HedayaAli/Self-balancing-/sbr-design/Our project/blue-wheel-for-hobby-robotics/Renderings/Isometric view.PNG

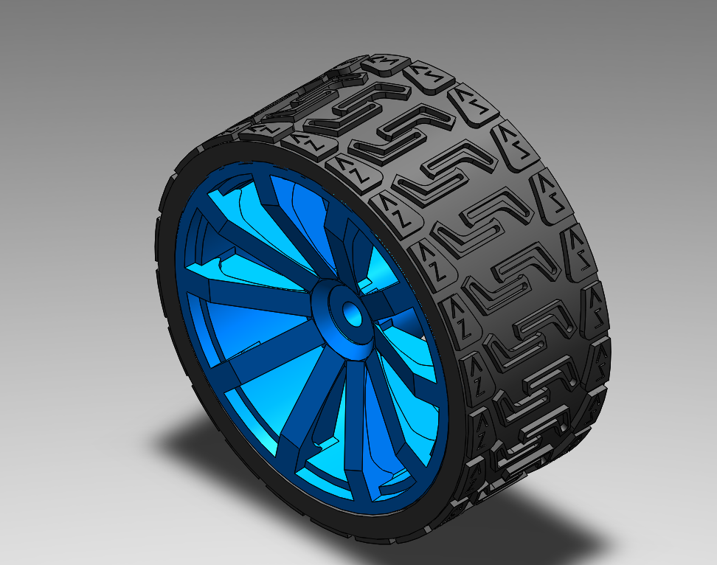
sbr-design/Our project/blue-wheel-for-hobby-robotics/Renderings/Isometric view.PNG
