HedayaAli/Self-balancing-/sbr-design/3.JPG

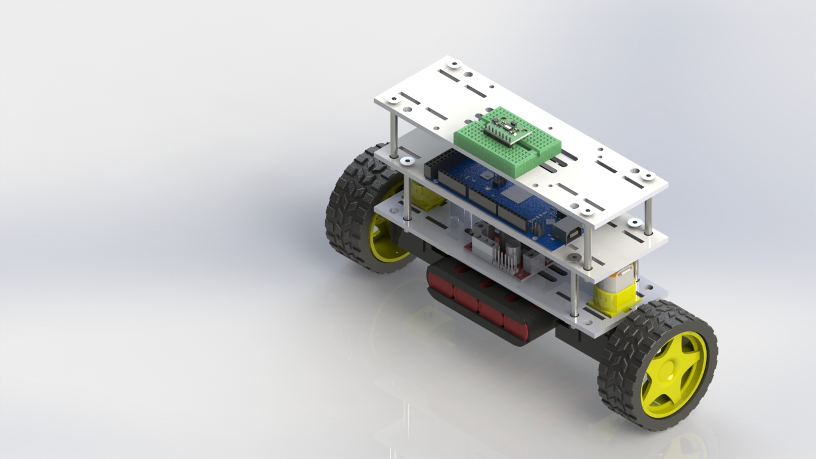
sbr-design/3.JPG
