HedayaAli/Self-balancing-/Presentation/Presentation.pdf

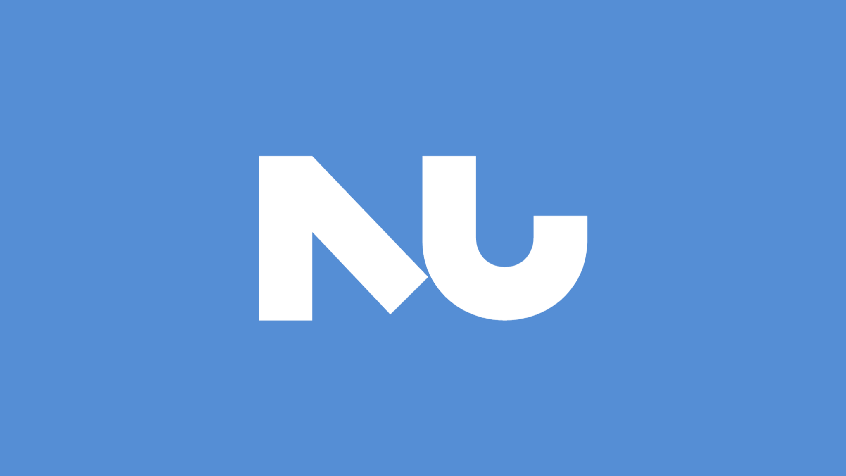
[picture p21: page 1]
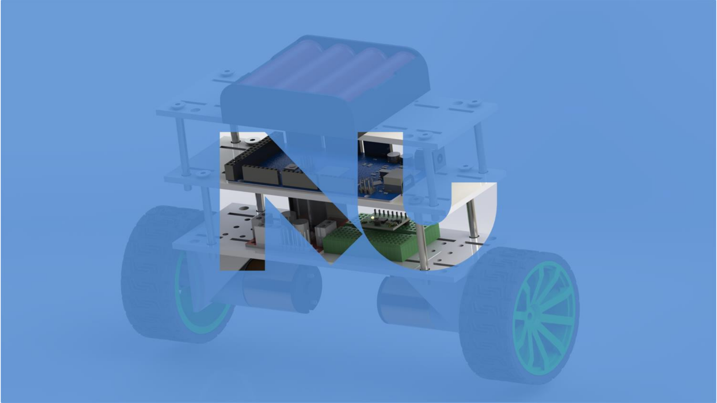
[picture p22: page 2]
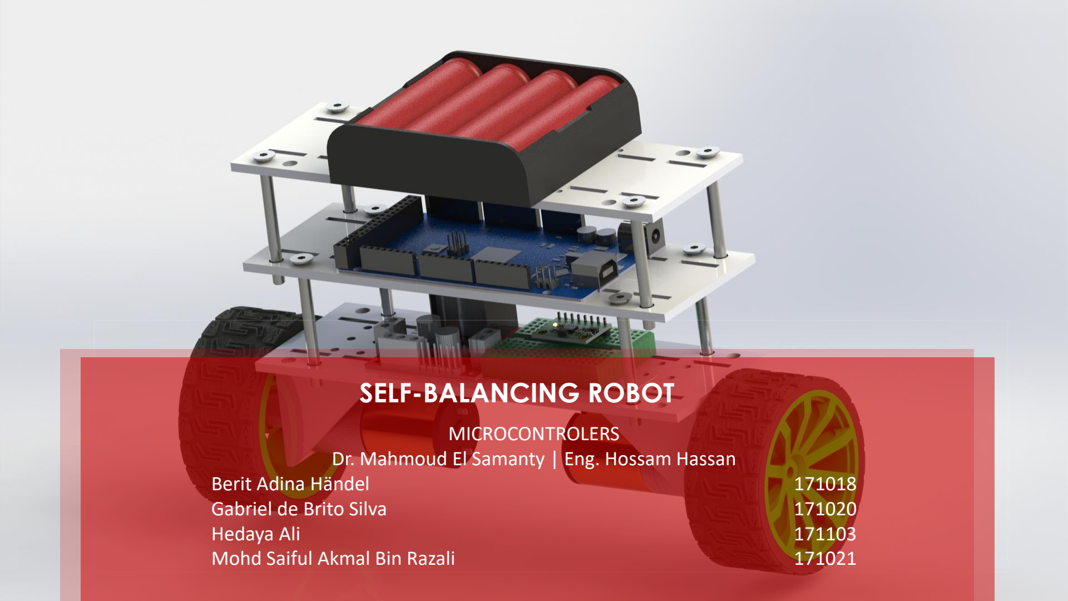
[picture p23: page 3]

### SELF-BALANCING ROBOT

MICROCONTROLERS
Dr. Mahmoud El Samanty | Eng. Hossam Hassan
Berit Adina Händel | 171018
Gabriel de Brito Silva | 171020
Hedaya Ali | 171103
Mohd Saiful Akmal Bin Razali | 171021

### OBJECTIVES

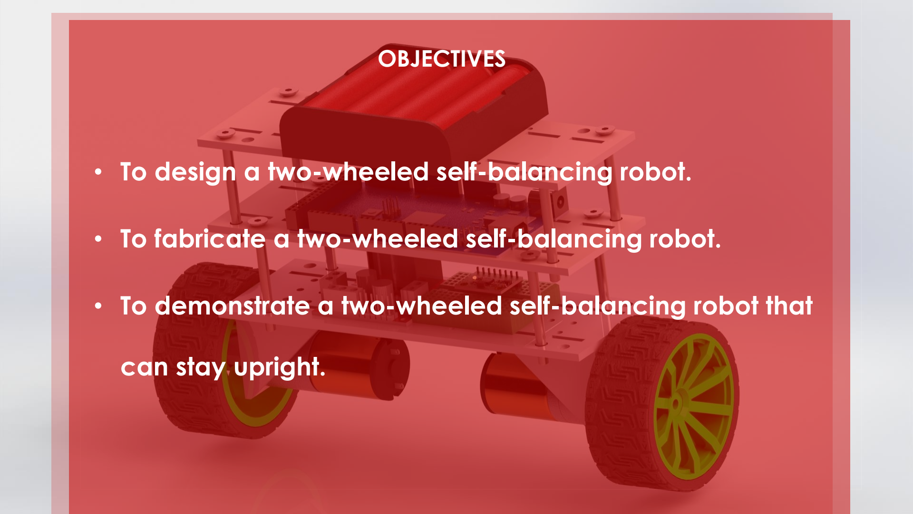
[picture p24: page 4]

- To design a two-wheeled self-balancing robot.
- To fabricate a two-wheeled self-balancing robot.

## - To demonstrate a two-wheeled self-balancing robot that

can stay upright.

# INVERTED PENDULUM

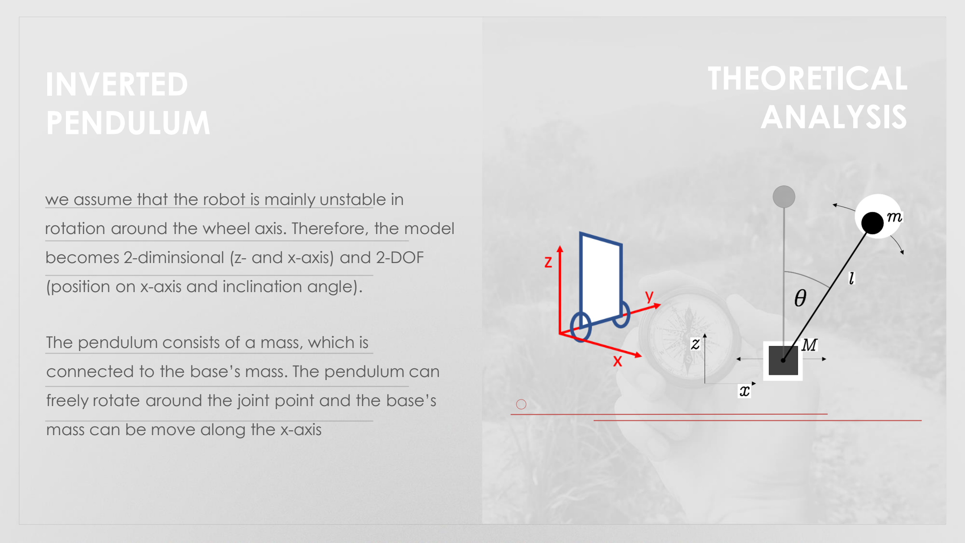
[picture p25: page 5]

The pendulum consists of a mass, which is

connected to the base’s mass. The pendulum can

freely rotate around the joint point and the base’s

mass can be move along the x-axis

we assume that the robot is mainly unstable in

rotation around the wheel axis. Therefore, the model

becomes 2-diminsional (z- and x-axis) and 2-DOF

(position on x-axis and inclination angle).

# THEORETICAL ANALYSIS

# THEORETICAL ANALYSIS

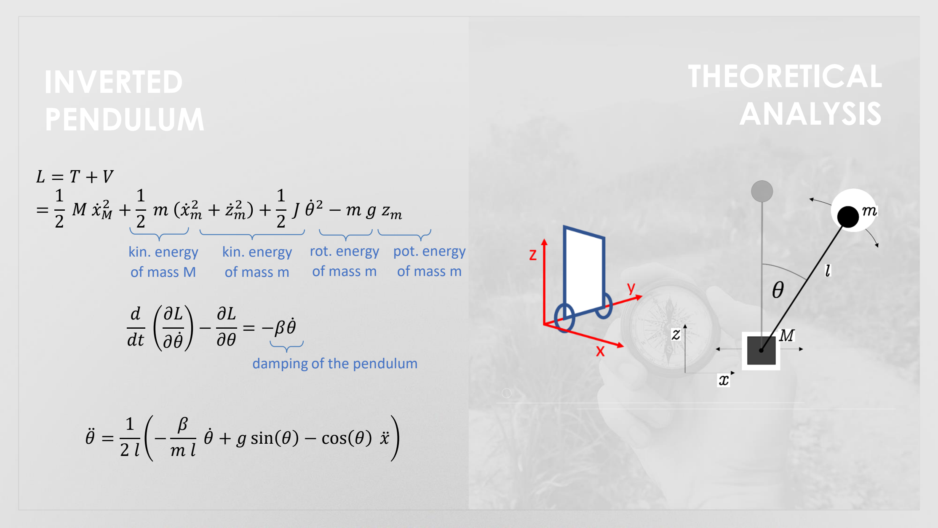
[picture p26: page 6]

L = T + V

=

1
2

M xሶM

2 +

1
2

m xሶm

2 + zሶm

2 +

1
2

J θሶ² − m g zm

kin. energy
of mass m

kin. energy
of mass M

rot. energy
of mass m

pot. energy
of mass m

d
dt

∂L
∂θሶ

−

∂L
∂θ

= −βθሶ

damping of the pendulum

θሷ=

1
2 l

−

β
m l

θሶ + g sin θ − cos θ xሷ

# INVERTED PENDULUM

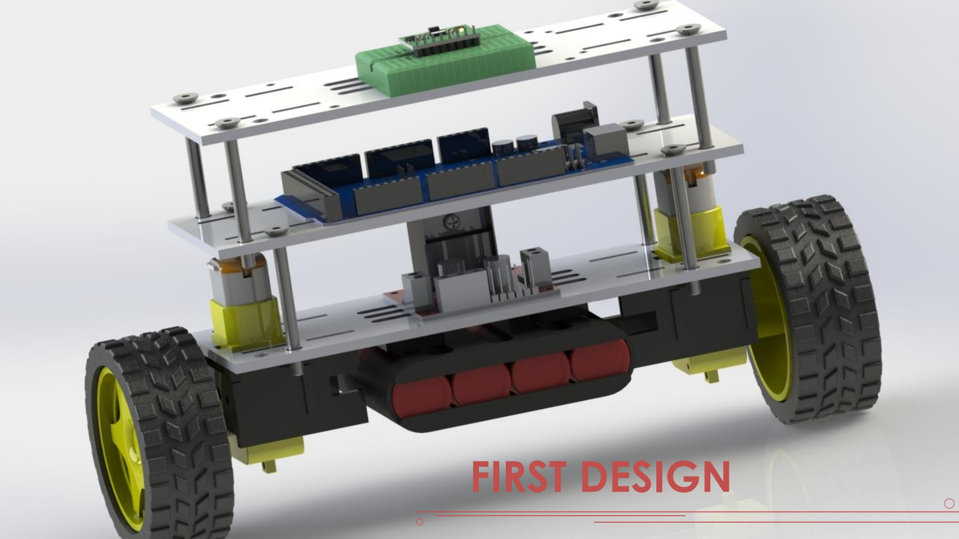
[picture p27: page 7]

# FIRST DESIGN

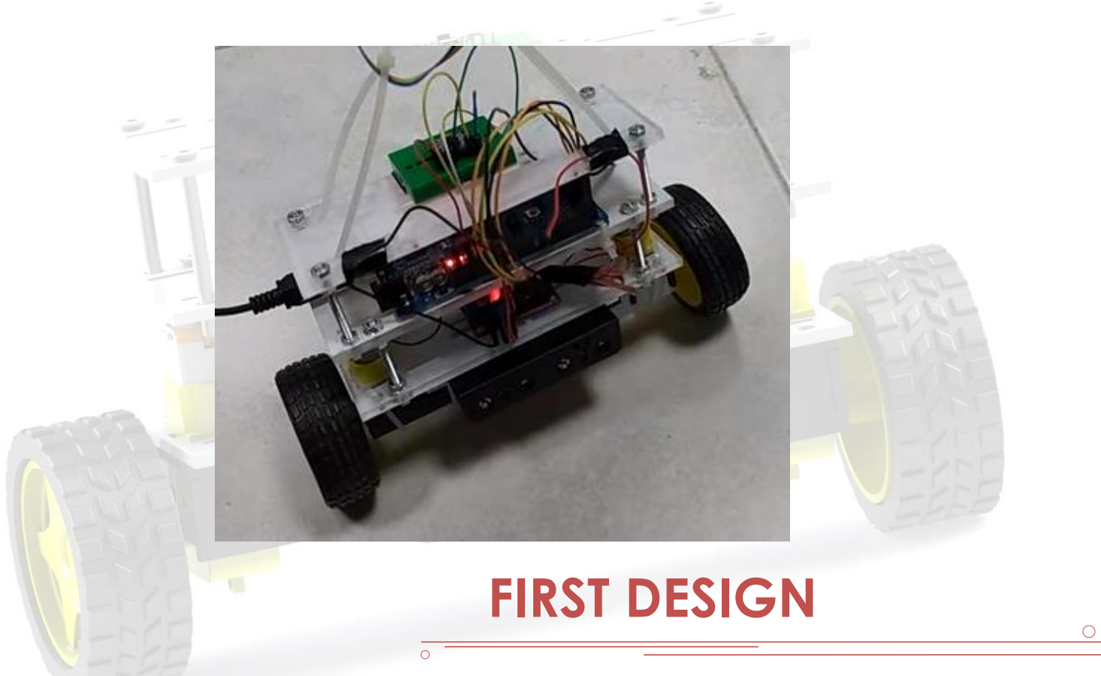
[picture p28: page 8]

# FIRST DESIGN

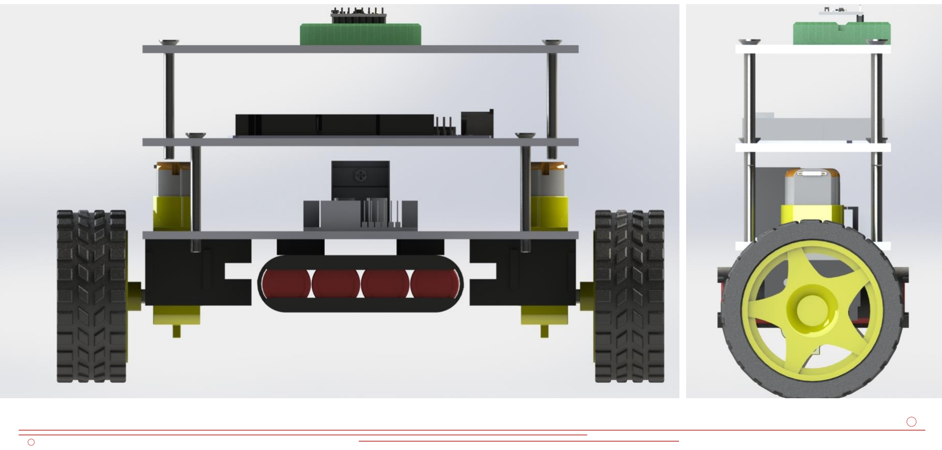
[picture p29: page 9]

# NOME DO APRESENTADOR

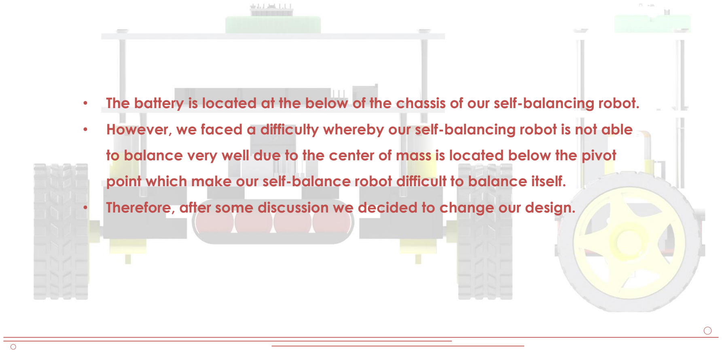
[picture p30: page 10]

# NOME DO APRESENTADOR

- The battery is located at the below of the chassis of our self-balancing robot.
- However, we faced a difficulty whereby our self-balancing robot is not able

to balance very well due to the center of mass is located below the pivot

point which make our self-balance robot difficult to balance itself.

- Therefore, after some discussion we decided to change our design.

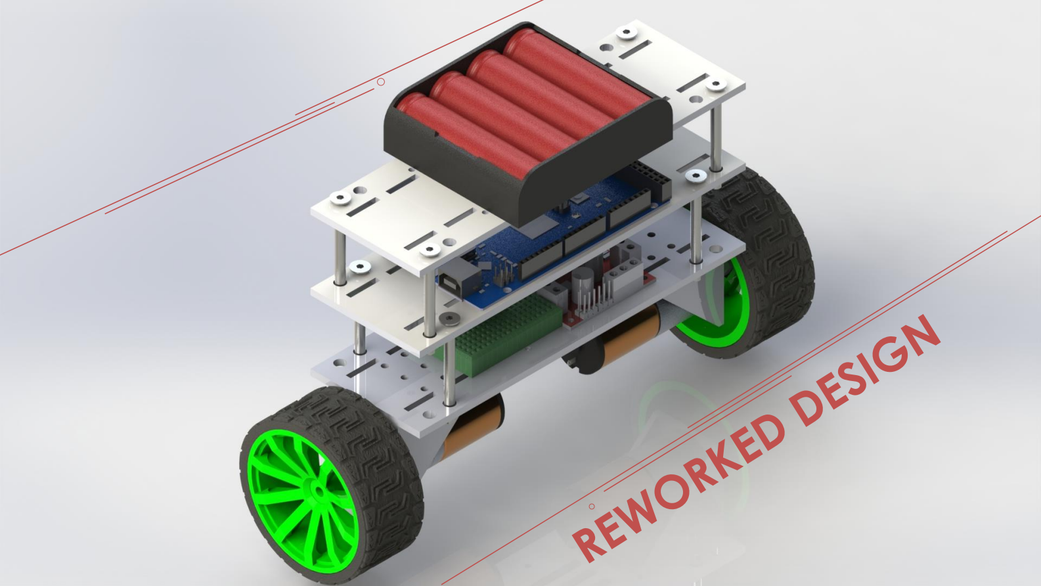
[picture p31: page 11]

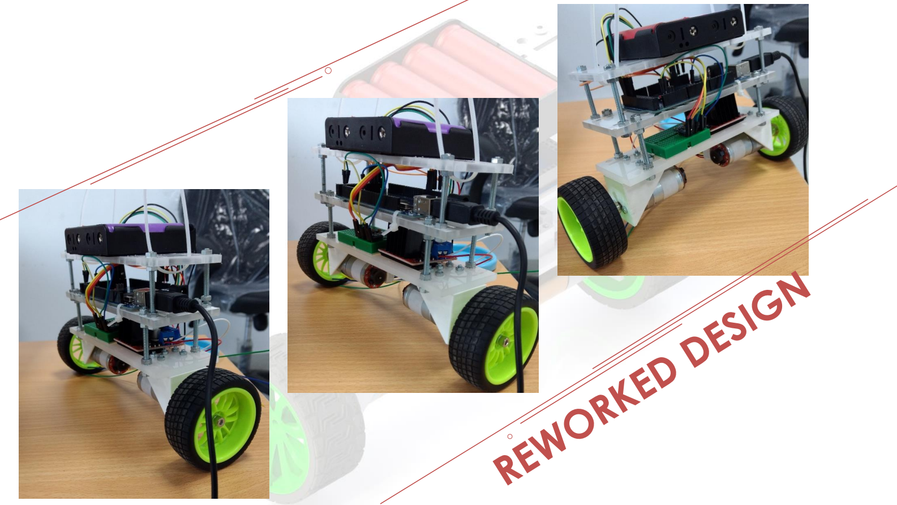
[picture p32: page 12]

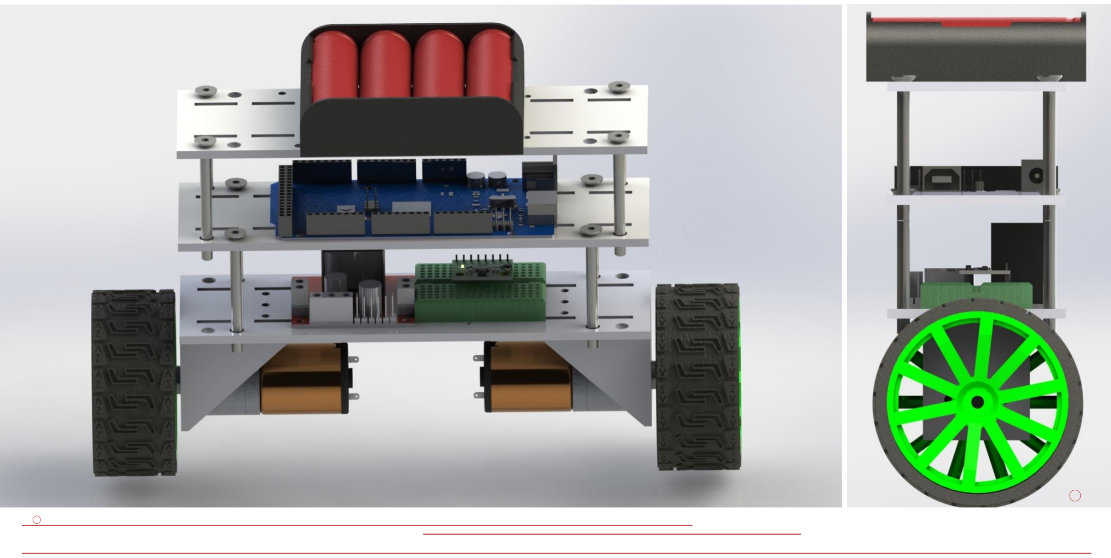
[picture p33: page 13]

# NOME DO APRESENTADOR

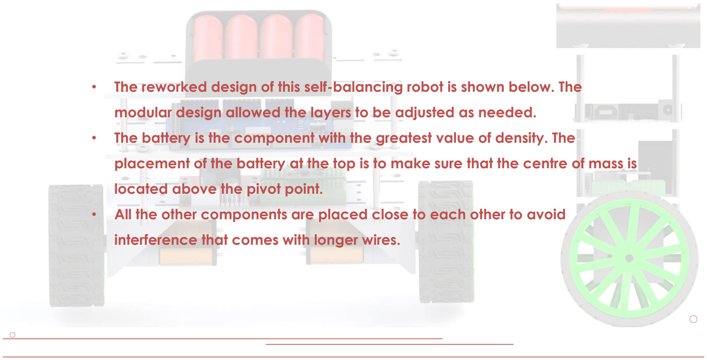
[picture p34: page 14]

# NOME DO APRESENTADOR

- The reworked design of this self-balancing robot is shown below. The

modular design allowed the layers to be adjusted as needed.

- The battery is the component with the greatest value of density. The

placement of the battery at the top is to make sure that the centre of mass is

located above the pivot point.

- All the other components are placed close to each other to avoid

interference that comes with longer wires.

# COMPONENTS AND CONNECTIONS

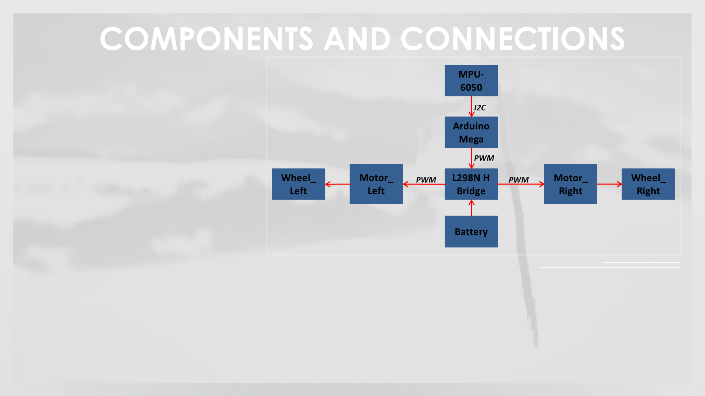
[picture p35: page 15]

# COMPONENTS AND CONNECTIONS

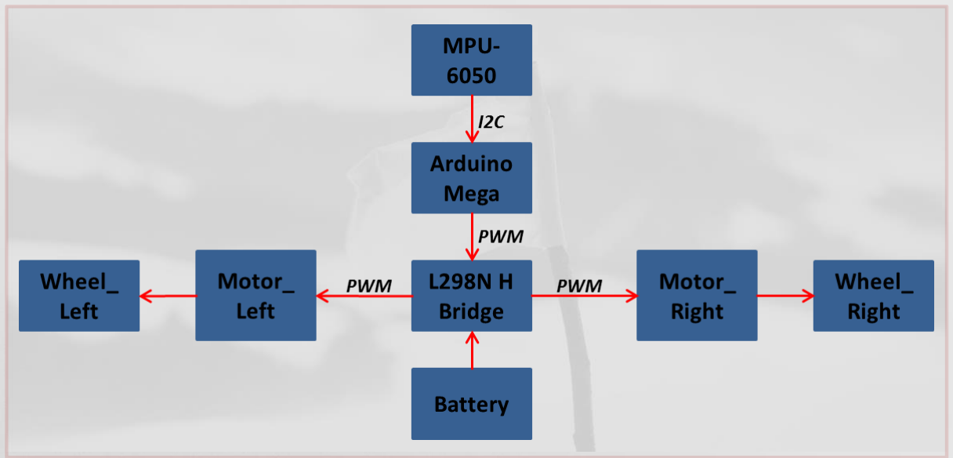
[picture p36: figure]

- Arduino Mega will read a
raw | data | from | the
measurement | sub-system
which in this case is MPU-6050.
- Arduino Mega reads raw
data from the measurement
sub-system and sends PWM
signals to the motor driver to be converted to mechanical motion.

# COMPONENTS AND CONNECTIONS

- | When | fresh | IMU | data | is
received, the MPU-6050 filters out sensor noise, and then fuse the data from the two sensors together to produce a single reading of tilt.
- Once the current tilt is known, the MPU-6050 calculates the error from the desired tilt, in this case the vertical, and then uses PID to control the PWM output to the motor driver sub-
| system.

# SIMULATION

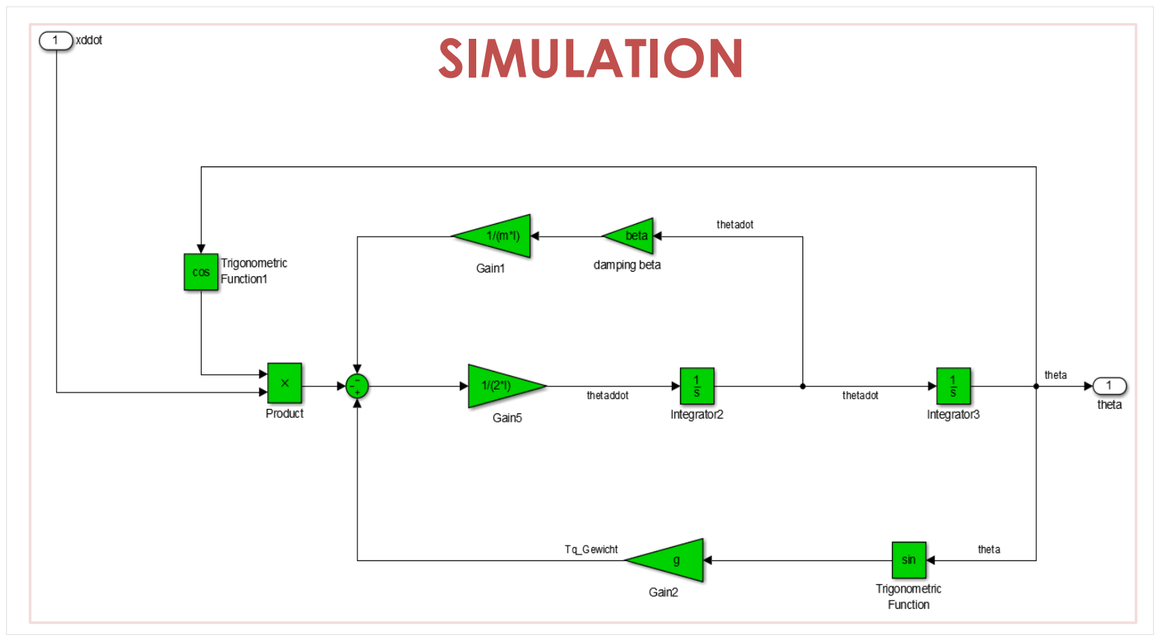
[picture p37: page 18]

# SIMULATION

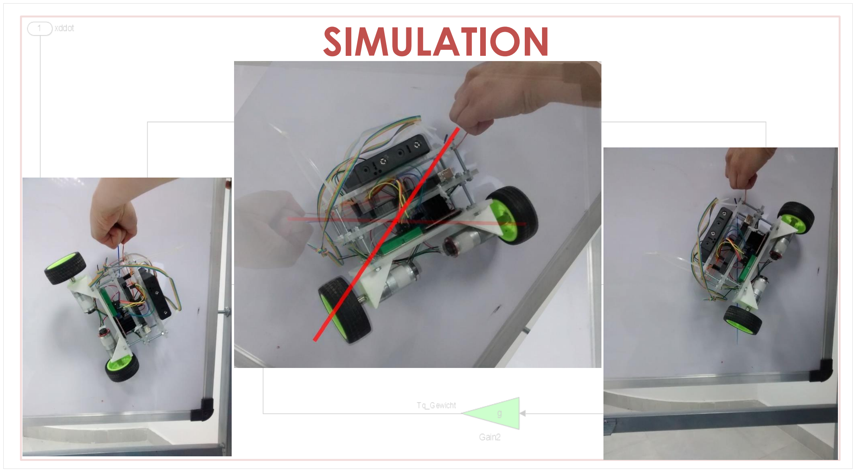
[picture p38: page 19]

# SIMULATION

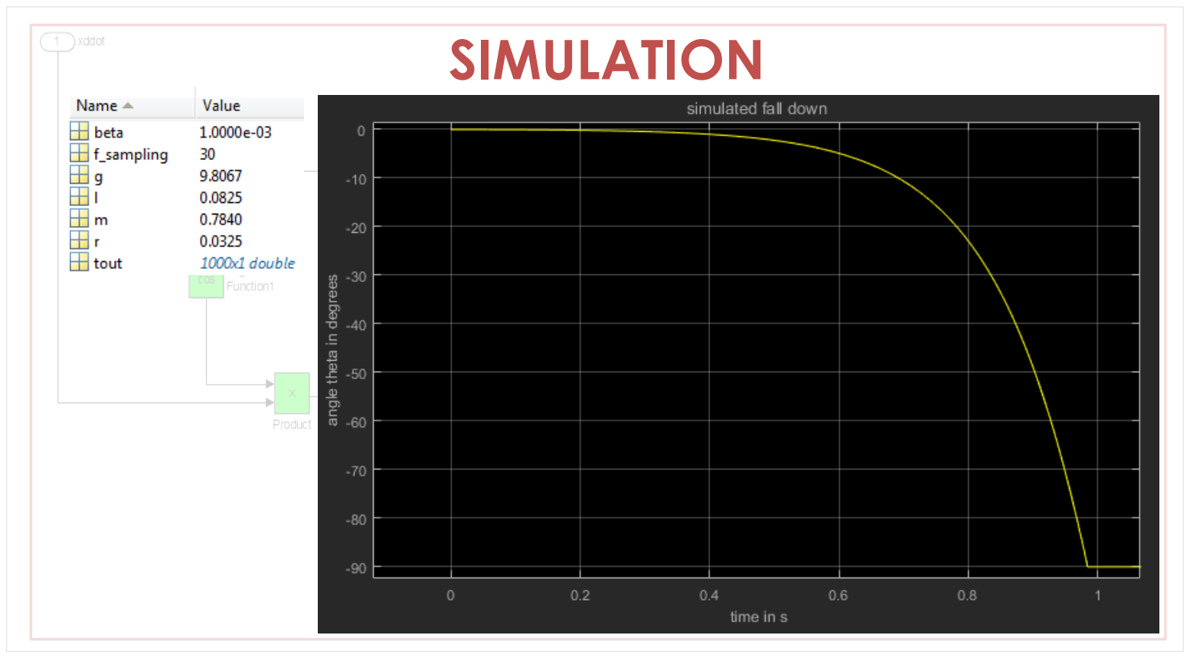
[picture p39: page 20]

# DEMONSTRATION

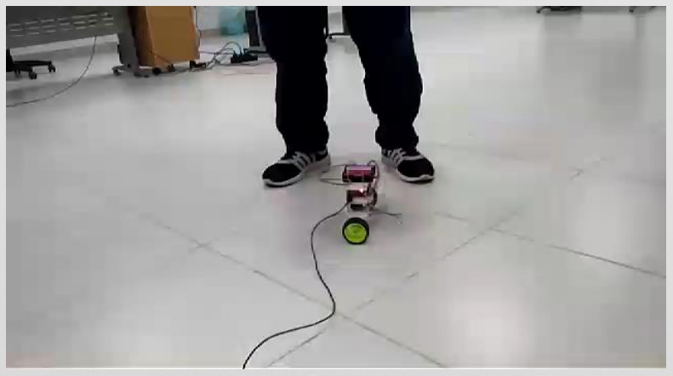
[picture p40: figure]
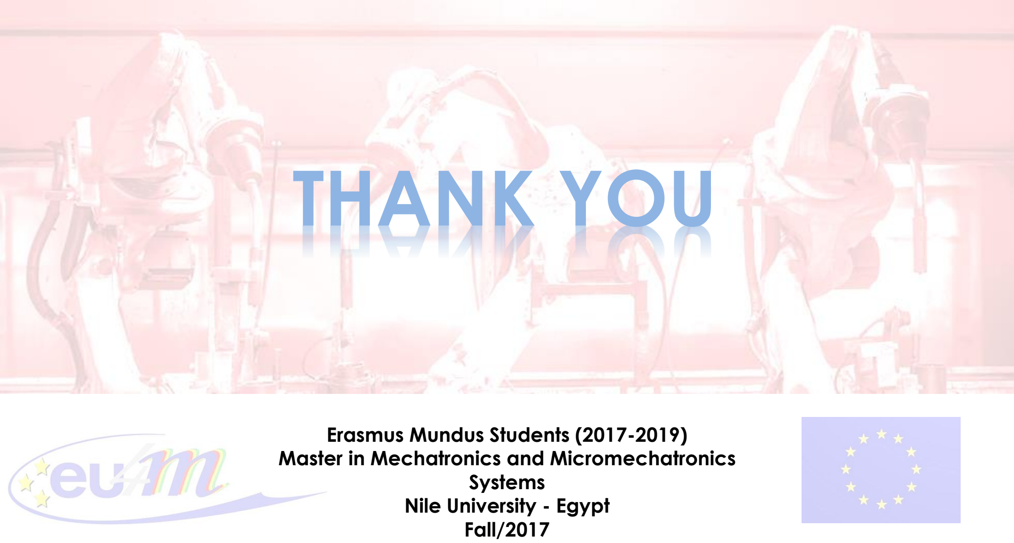
[picture p41: page 22]

Erasmus Mundus Students (2017-2019) Master in Mechatronics and Micromechatronics Systems
Nile University - Egypt
Fall/2017

# THANK YOU
