HedayaAli/Self-balancing-/Presentation/18767786_10155315623932354_1492730836537449931_n.jpg

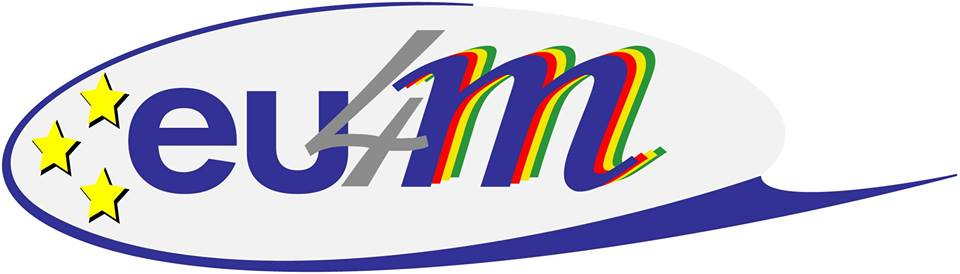
Presentation/18767786_10155315623932354_1492730836537449931_n.jpg
