HedayaAli/Self-balancing-/Presentation/eu_flag_high_res.png

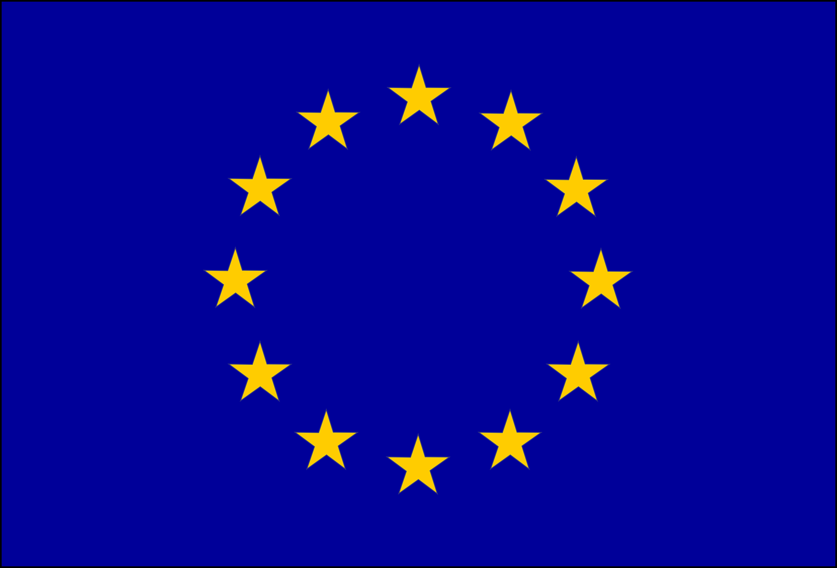
Presentation/eu_flag_high_res.png
