HedayaAli/Self-balancing-/Presentation/image_gallery.png

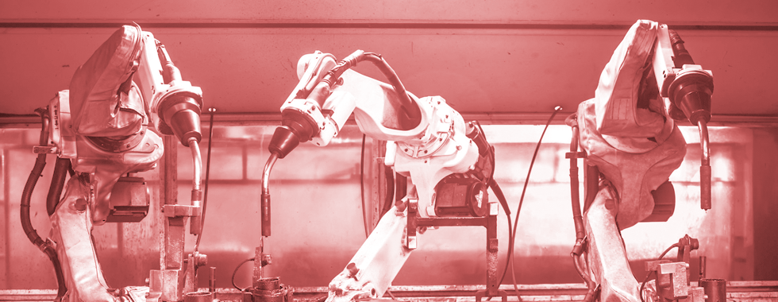
Presentation/image_gallery.png
