HedayaAli/Self-balancing-/Presentation/IMG_20171206_141947142.jpg

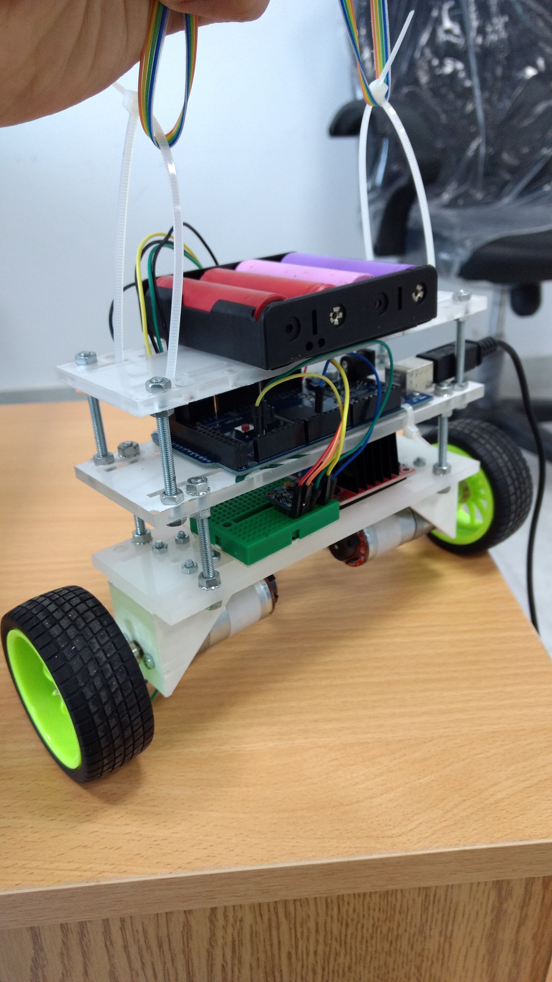
Presentation/IMG_20171206_141947142.jpg
