HedayaAli/Self-balancing-/Presentation/IMG_20171206_142010743_BURST000_COVER_TOP.jpg

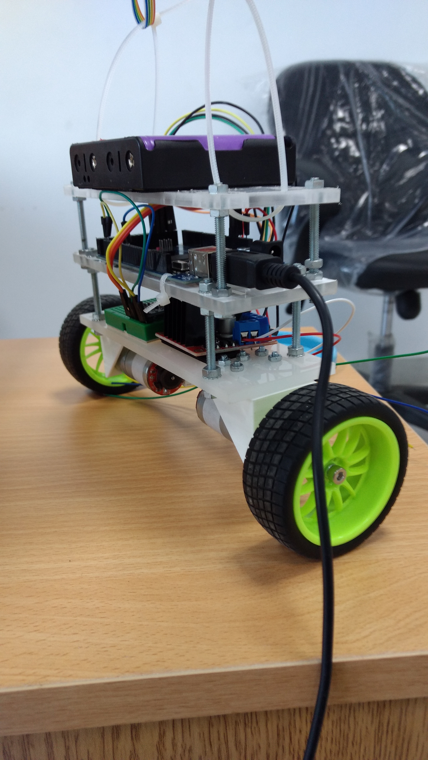
Presentation/IMG_20171206_142010743_BURST000_COVER_TOP.jpg
