HedayaAli/Self-balancing-/Presentation/IMG_20171206_142010743_BURST001.jpg

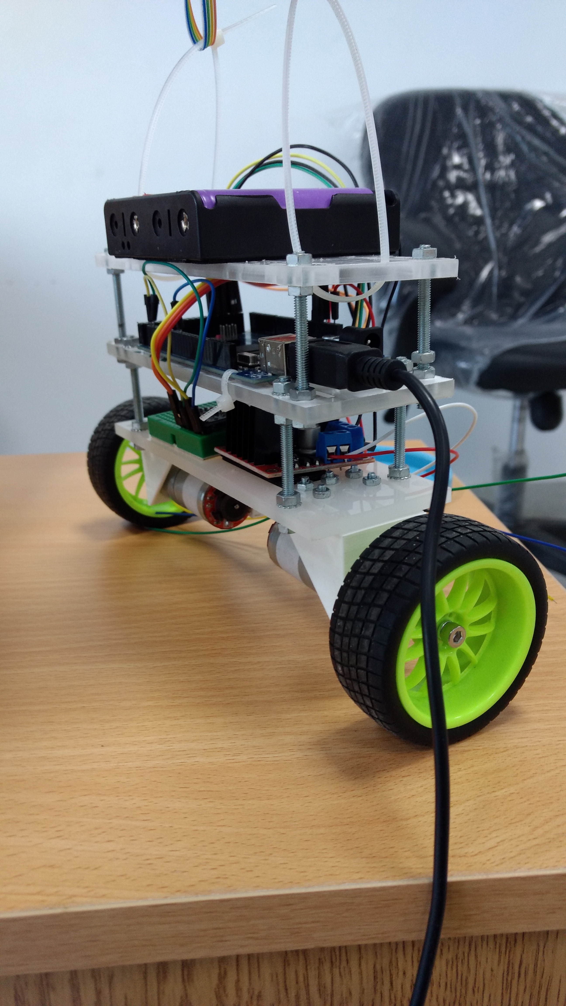
Presentation/IMG_20171206_142010743_BURST001.jpg
