HedayaAli/Self-balancing-/Presentation/IMG_20171206_142028458.jpg

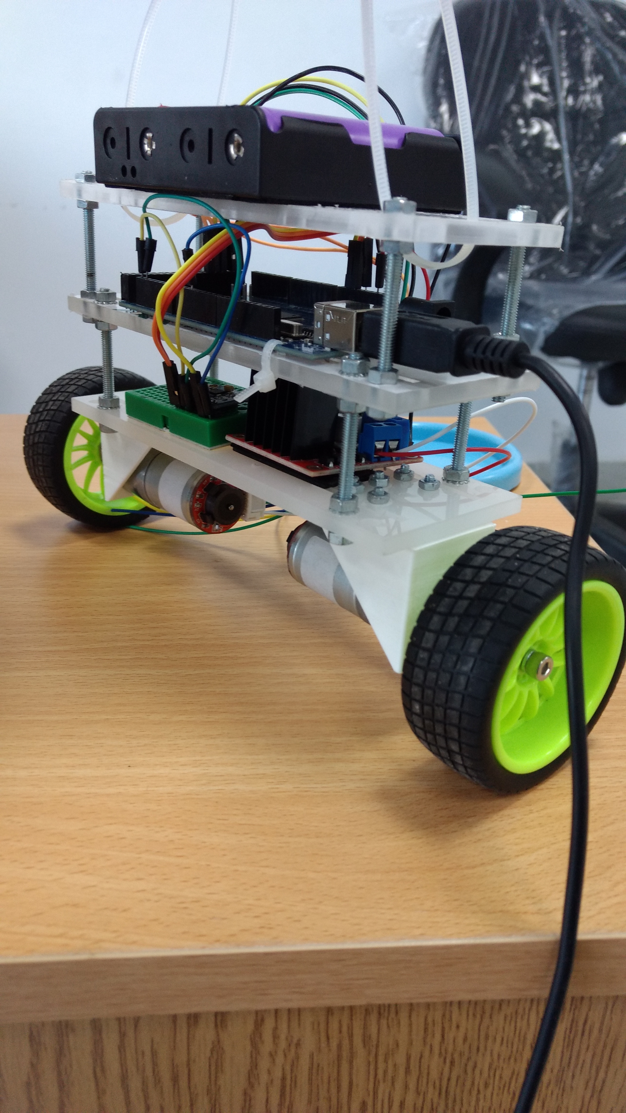
Presentation/IMG_20171206_142028458.jpg
