HedayaAli/Self-balancing-/Presentation/index2.jpg

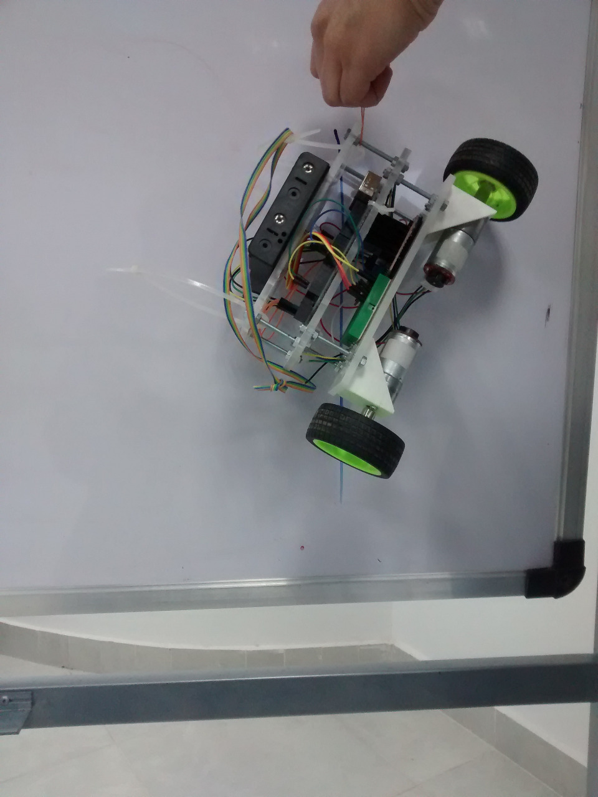
Presentation/index2.jpg
