HedayaAli/Self-balancing-/Presentation/index3.jpg

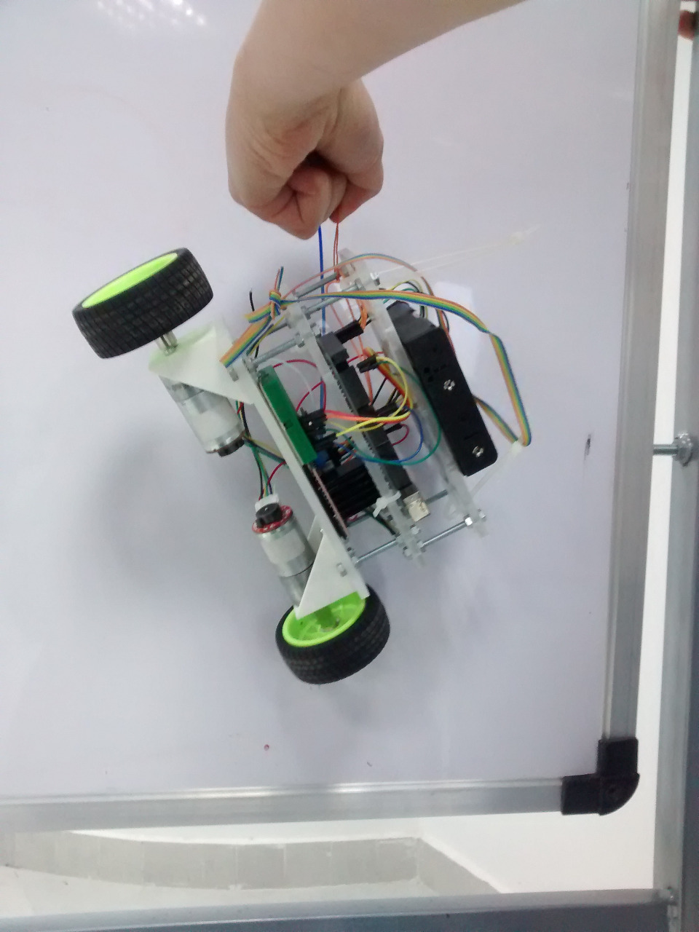
Presentation/index3.jpg
