HedayaAli/Self-balancing-/Presentation/index.jpg

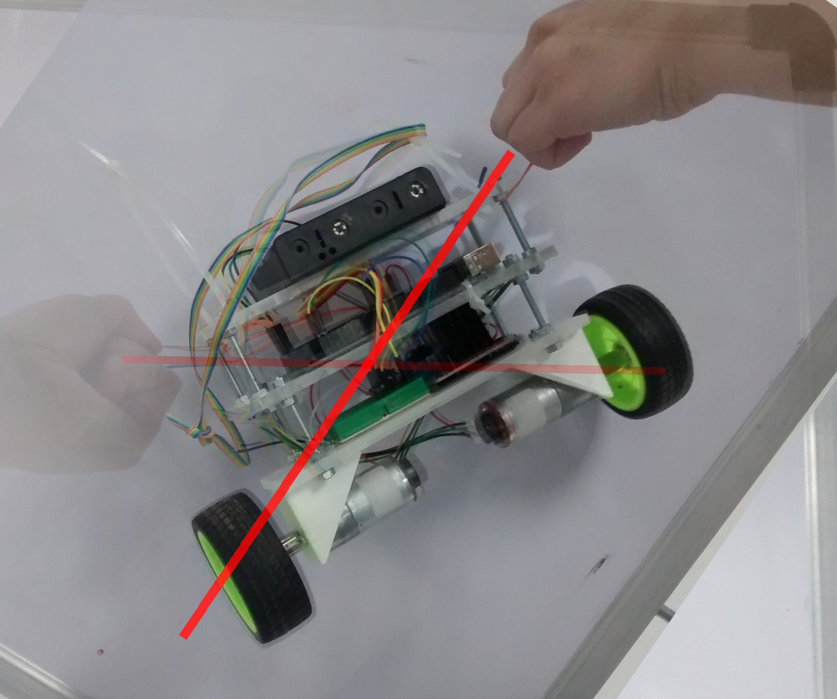
Presentation/index.jpg
