HedayaAli/Self-balancing-/Presentation/Screenshot (11).png

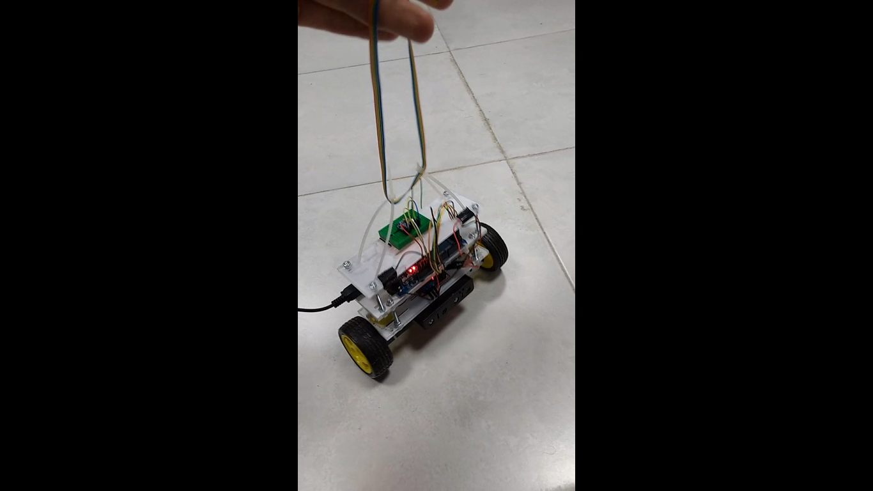
Presentation/Screenshot (11).png
