HedayaAli/Self-balancing-/Presentation/Screenshot (13).png

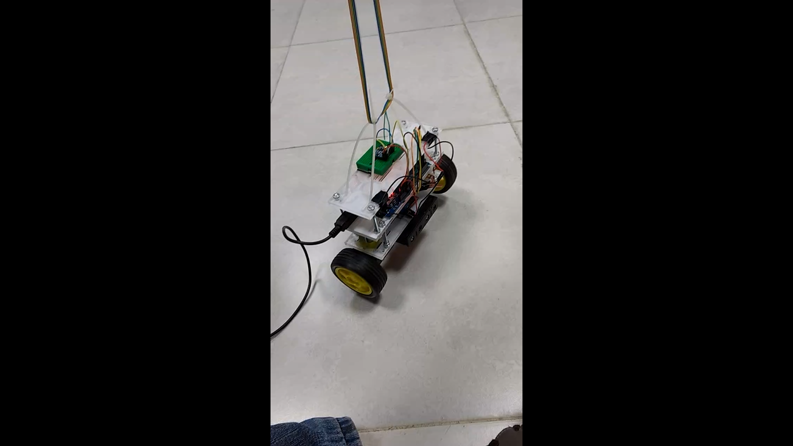
Presentation/Screenshot (13).png
