HedayaAli/Self-balancing-/sbr-design/1.JPG

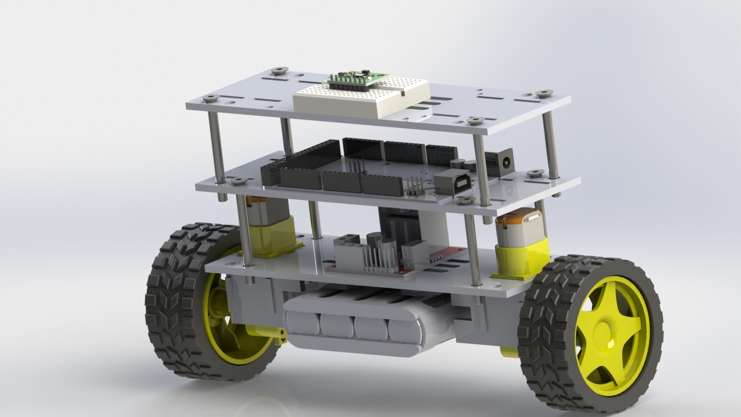
sbr-design/1.JPG
