HedayaAli/Self-balancing-/sbr-design/2.JPG

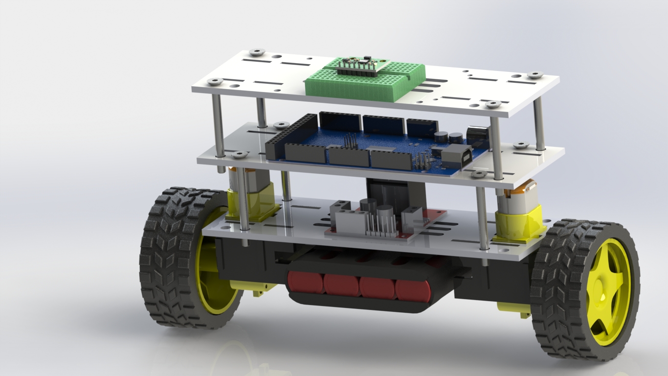
sbr-design/2.JPG
