HedayaAli/Self-balancing-/sbr-design/4.JPG

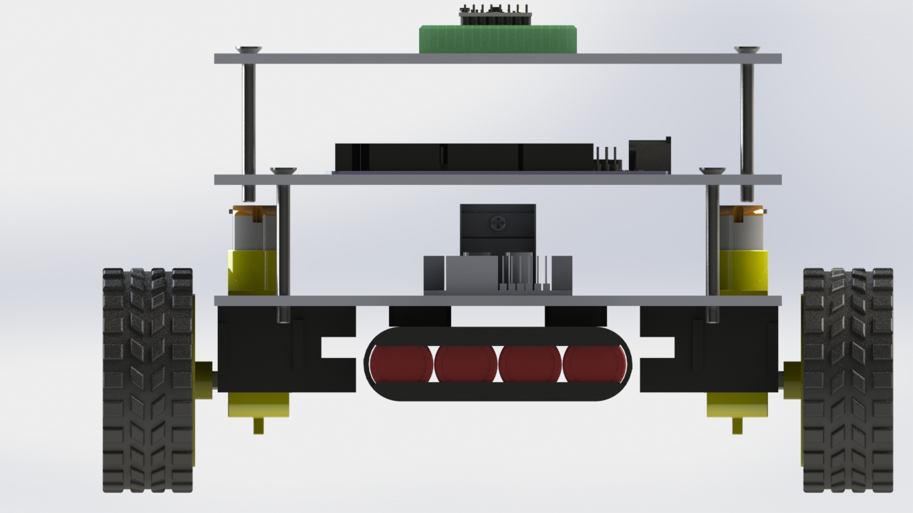
sbr-design/4.JPG
