HedayaAli/Self-balancing-/sbr-design/6.JPG

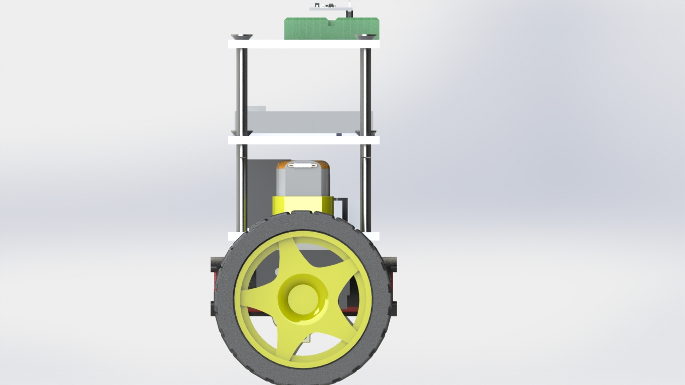
sbr-design/6.JPG
