HedayaAli/Self-balancing-/sbr-design/7.JPG

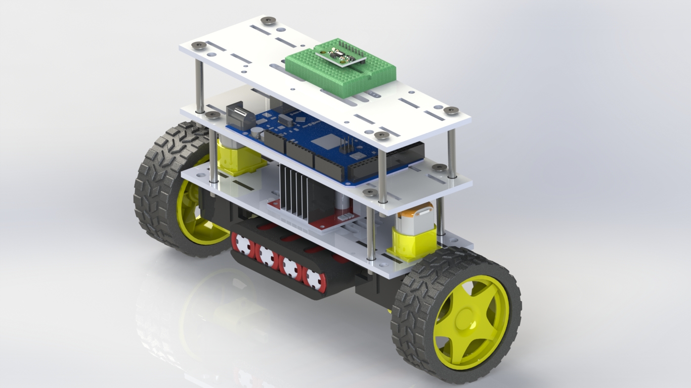
sbr-design/7.JPG
