HedayaAli/Self-balancing-/sbr-design/13.JPG

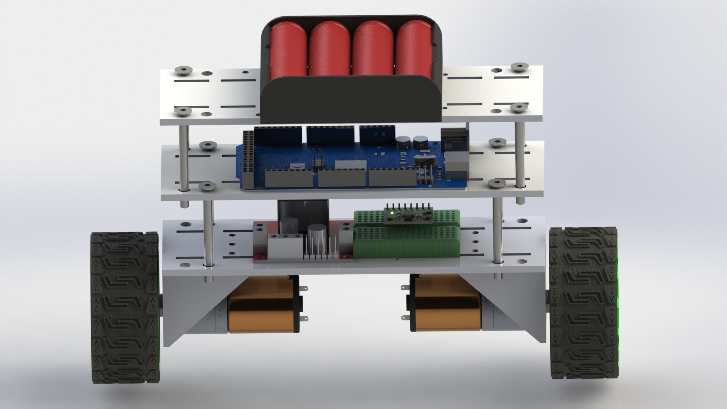
sbr-design/13.JPG
