HedayaAli/Self-balancing-/sbr-design/14.JPG

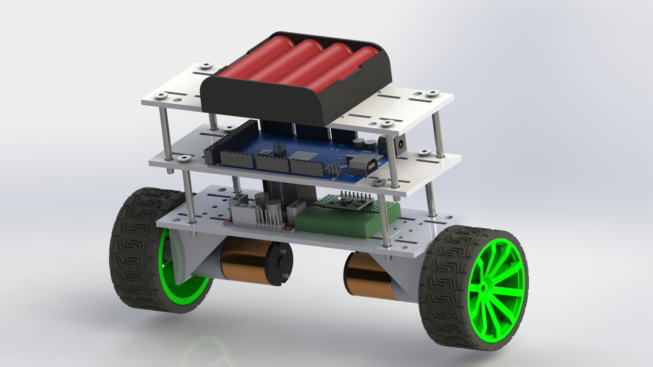
sbr-design/14.JPG
