HedayaAli/Self-balancing-/sbr-design/Our project/4p-18650-cartridge.snapshot.1/4P.JPG

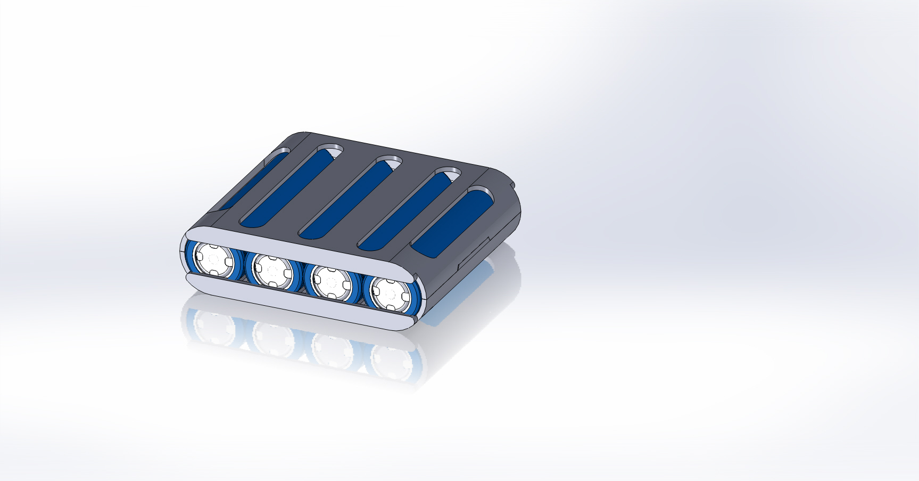
sbr-design/Our project/4p-18650-cartridge.snapshot.1/4P.JPG
