HedayaAli/Self-balancing-/sbr-design/Our project/arduino-mega-2560-3.snapshot.1/ArduinoMega2560/arduino-mega-2560-microcontroller-back.jpg

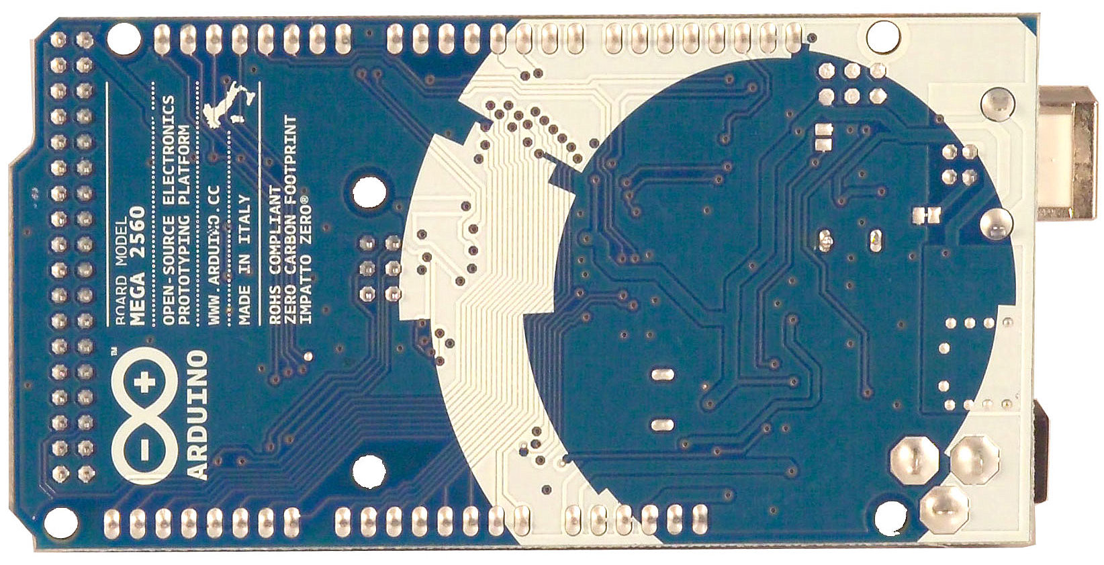
sbr-design/Our project/arduino-mega-2560-3.snapshot.1/ArduinoMega2560/arduino-mega-2560-microcontroller-back.jpg
