HedayaAli/Self-balancing-/sbr-design/Our project/arduino-mega-2560-3.snapshot.1/ArduinoMega2560/arduino.png

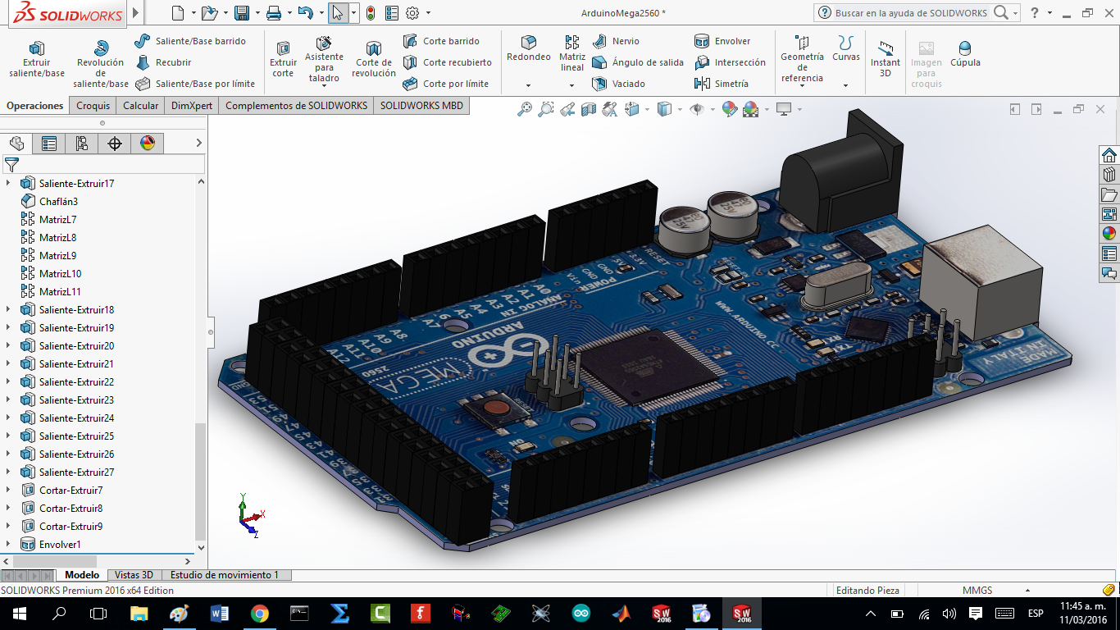
sbr-design/Our project/arduino-mega-2560-3.snapshot.1/ArduinoMega2560/arduino.png
