HedayaAli/Self-balancing-/sbr-design/Our project/arduino-mega-2560-3.snapshot.1/ArduinoMega2560/arduinomega2560_r2_front.jpg

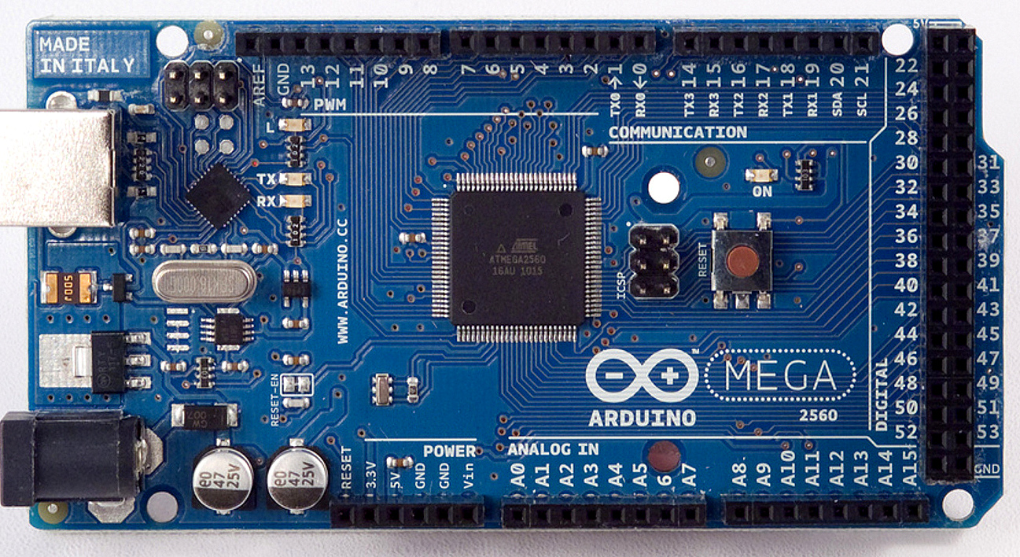
sbr-design/Our project/arduino-mega-2560-3.snapshot.1/ArduinoMega2560/arduinomega2560_r2_front.jpg
