HedayaAli/Self-balancing-/sbr-design/Our project/arduino-mega-2560-corrcted-1.snapshot.1/Arduino MEGA 2560 CORRECTED.png

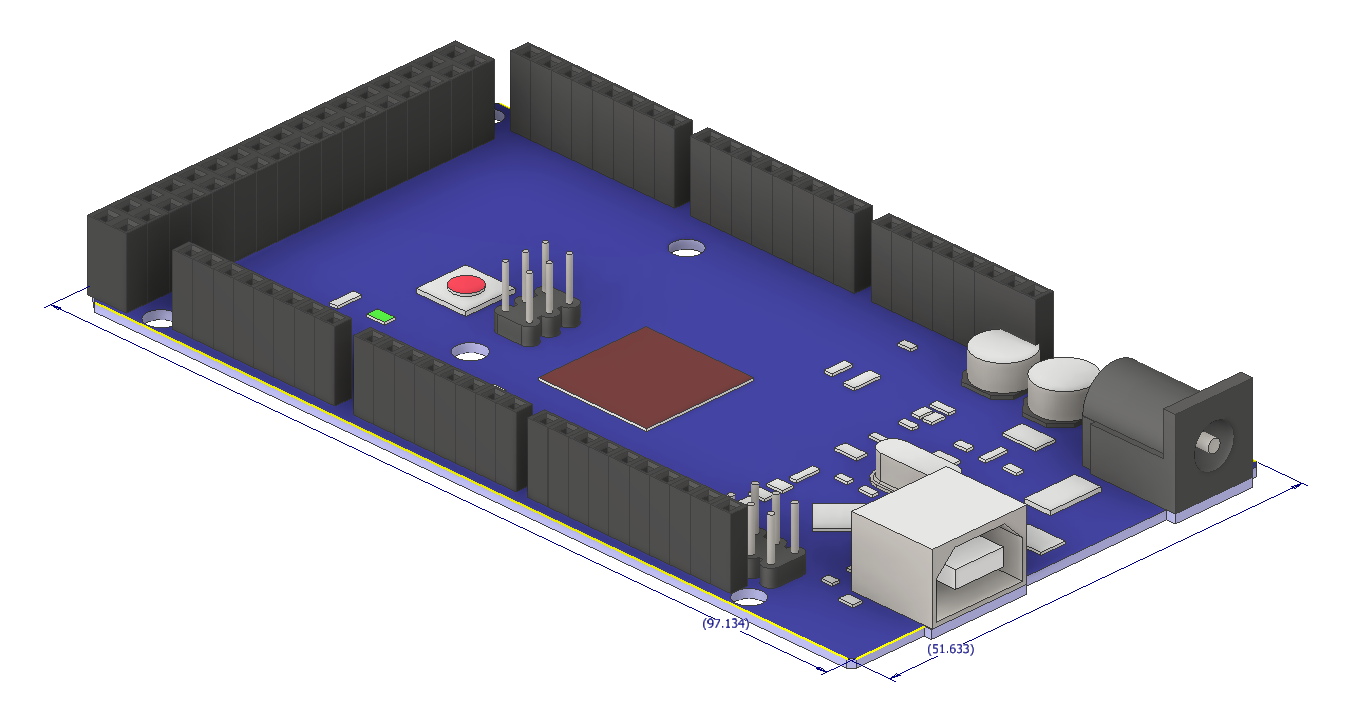
sbr-design/Our project/arduino-mega-2560-corrcted-1.snapshot.1/Arduino MEGA 2560 CORRECTED.png
