HedayaAli/Self-balancing-/sbr-design/Our project/balance-robot-1.snapshot.4/Renderings/2.JPG

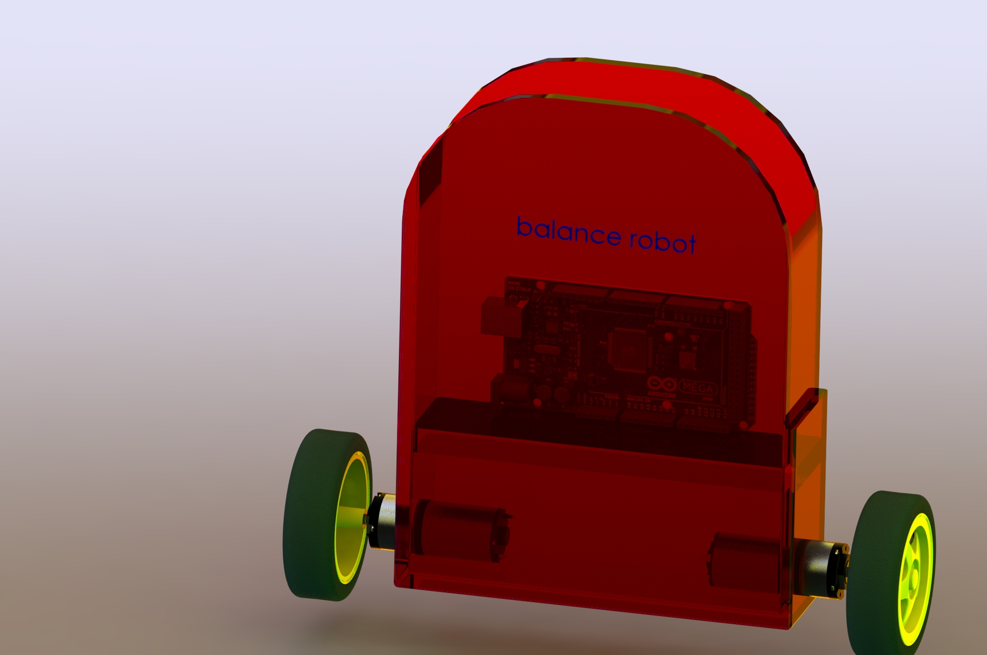
sbr-design/Our project/balance-robot-1.snapshot.4/Renderings/2.JPG
