HedayaAli/Self-balancing-/sbr-design/Our project/balance-robot-1.snapshot.4/Renderings/robot.gif

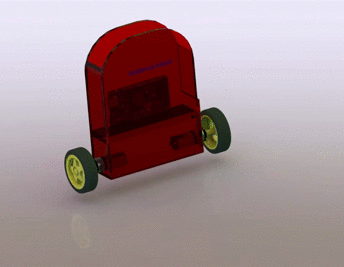
sbr-design/Our project/balance-robot-1.snapshot.4/Renderings/robot.gif
