HedayaAli/Self-balancing-/sbr-design/Our project/blue-wheel-for-hobby-robotics/Renderings/Expolded view.PNG

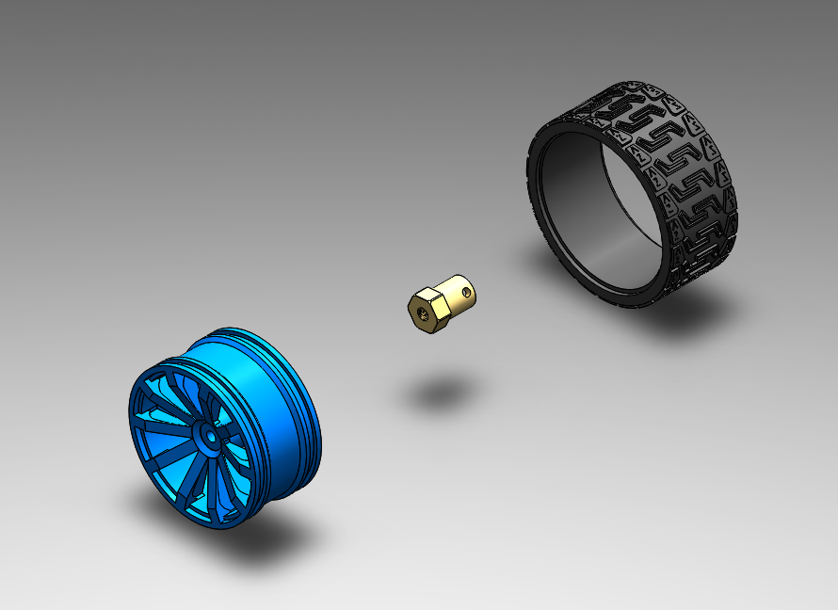
sbr-design/Our project/blue-wheel-for-hobby-robotics/Renderings/Expolded view.PNG
