HedayaAli/Self-balancing-/sbr-design/Our project/mini-breadboard.snapshot.2/Renderings/MiniBreadboard.JPG

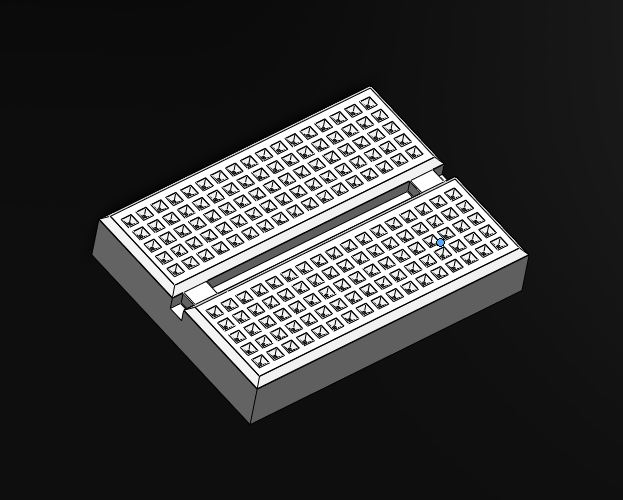
sbr-design/Our project/mini-breadboard.snapshot.2/Renderings/MiniBreadboard.JPG
