HedayaAli/Self-balancing-/sbr-design/Our project/motor-driver-l298n.snapshot.1/front 2.JPG

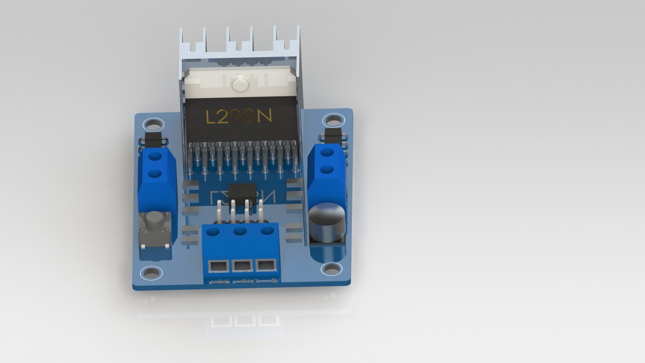
sbr-design/Our project/motor-driver-l298n.snapshot.1/front 2.JPG
