HedayaAli/Self-balancing-/sbr-design/Our project/motor-driver-l298n.snapshot.1/l298n.JPG

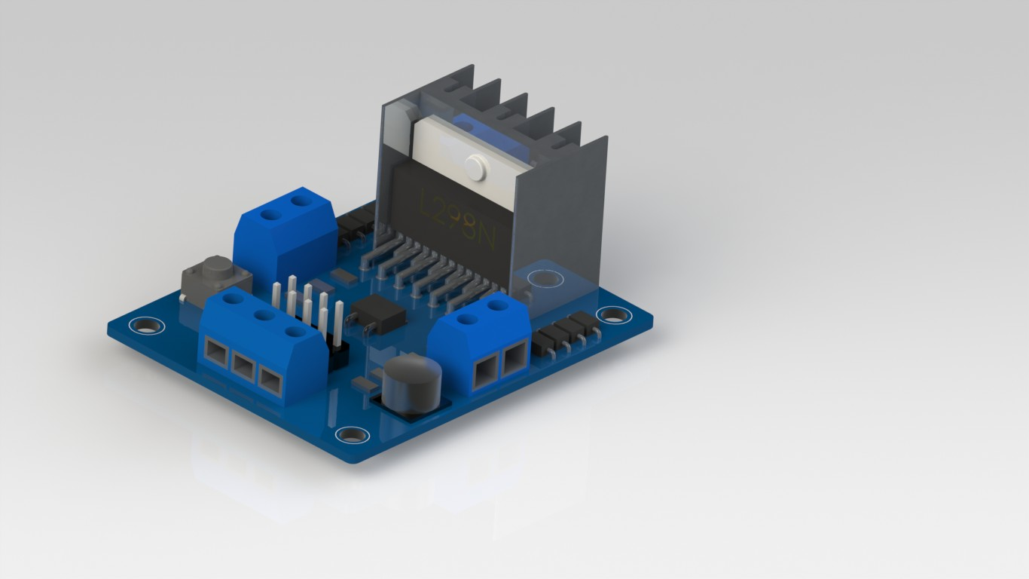
sbr-design/Our project/motor-driver-l298n.snapshot.1/l298n.JPG
