HedayaAli/Self-balancing-/sbr-design/Our project/motor-driver-l298n.snapshot.1/side.JPG

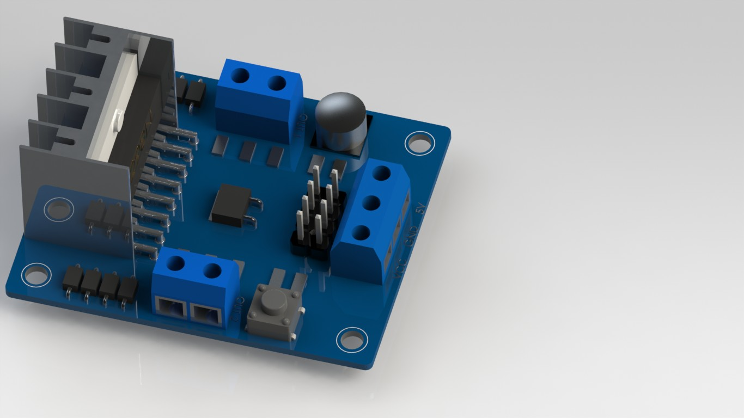
sbr-design/Our project/motor-driver-l298n.snapshot.1/side.JPG
