HedayaAli/Self-balancing-/sbr-design/Our project/robotdyn-mega-r3-1.snapshot.1/Capture1.PNG

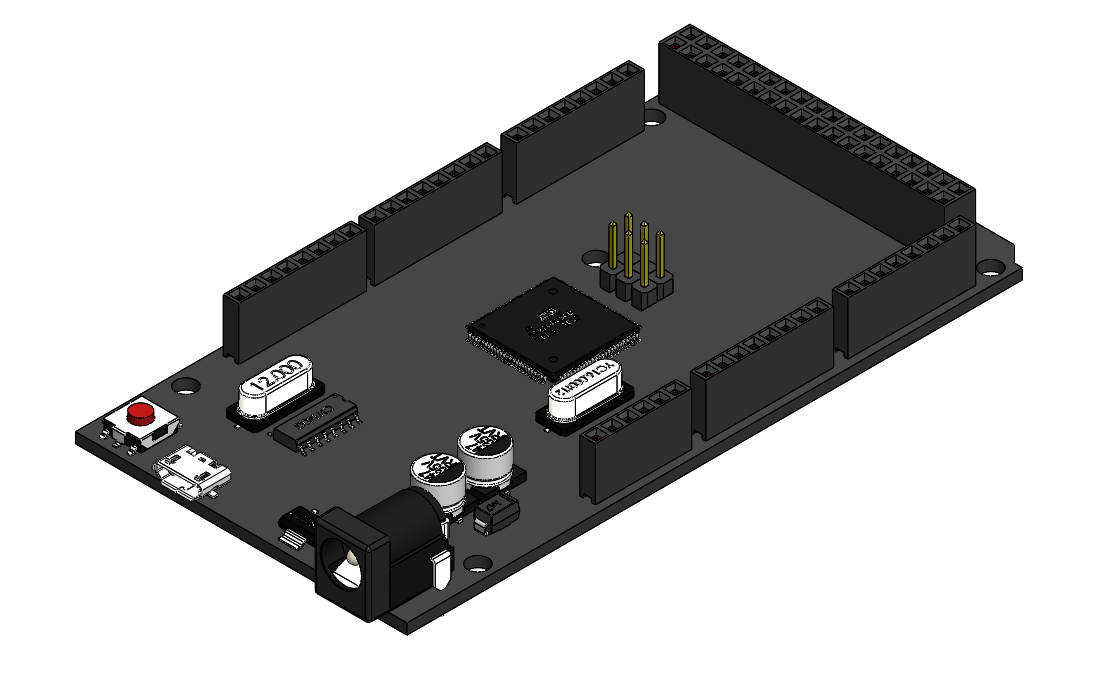
sbr-design/Our project/robotdyn-mega-r3-1.snapshot.1/Capture1.PNG
