HedayaAli/Self-balancing-/sbr-design/Our project/robotdyn-mega-r3-1.snapshot.1/Capture3.PNG

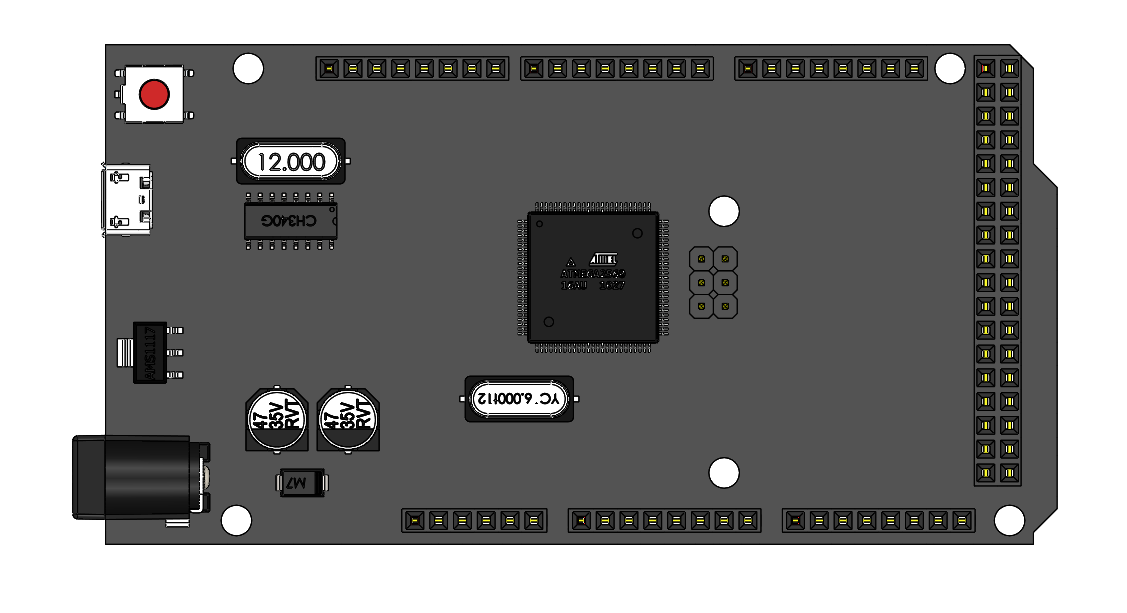
sbr-design/Our project/robotdyn-mega-r3-1.snapshot.1/Capture3.PNG
