HedayaAli/Self-balancing-/sbr-design/Our project/self-balancing-bot-1.snapshot.4/Snap shot 1.png

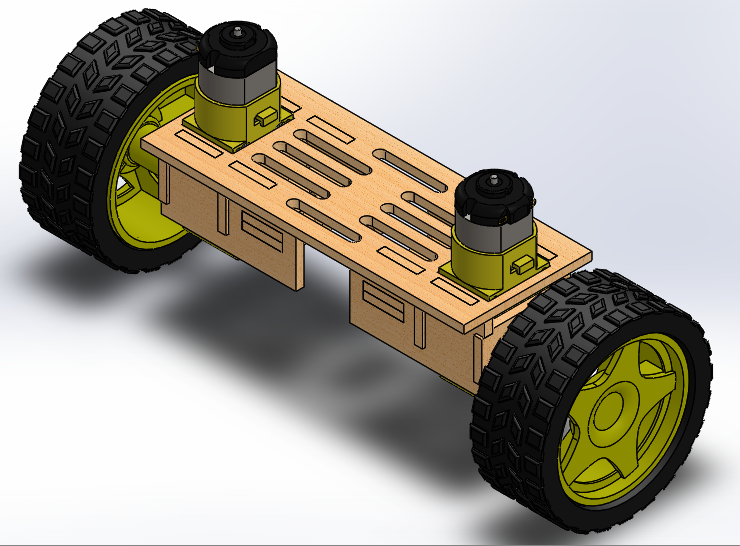
sbr-design/Our project/self-balancing-bot-1.snapshot.4/Snap shot 1.png
