HedayaAli/Self-balancing-/sbr-design/Our project/self-balancing-robot-2.snapshot.2/Self Balancing robot/render_1.JPG

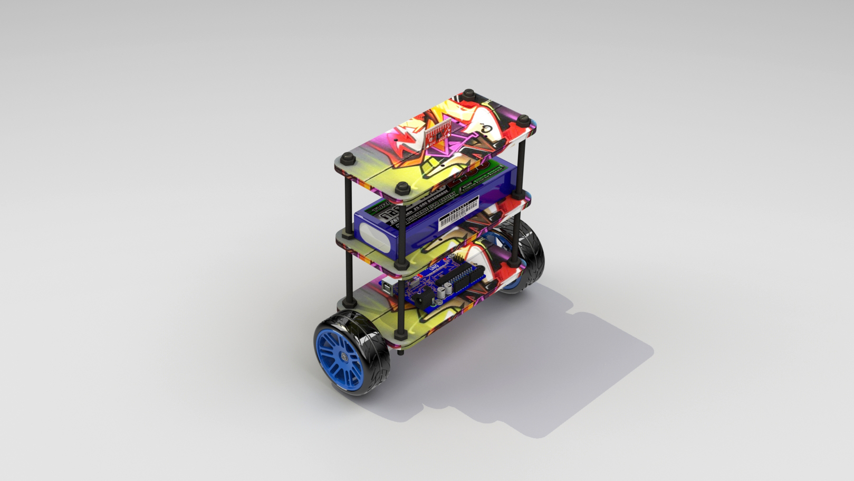
sbr-design/Our project/self-balancing-robot-2.snapshot.2/Self Balancing robot/render_1.JPG
