HedayaAli/Self-balancing-/sbr-documentation/coordsys.png

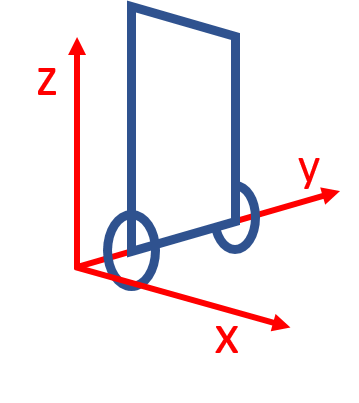
sbr-documentation/coordsys.png
