HedayaAli/Self-balancing-/sbr-design/Our project/Assem2-1.SLDASM

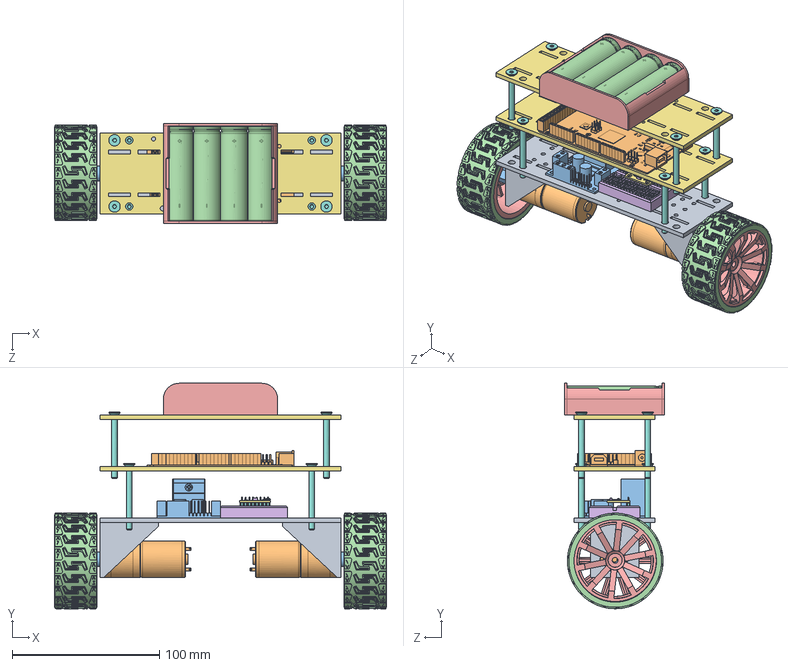
[picture p84: CAD file, 2017-12-05]
sbr-design/Our project/Assem2-1.SLDASM
225.6 x 153.3 x 67.8 mm
Base_top
ArduinoMega2560
l298n1
New4P_TRAY
MiniBreadboard
Base
pin header x 8
sensor chip
S2NH chip
Resistor small x 6
Resistor small black x 4
Small LED
Resistor black
Base_toptop x 2
socket countersunk head screw_am x 8
L HOLDER DC MOTOR x 2
JGA25-372 24V Motor x 2
Coupler x 2
65mm tire x 2
blue_wheel_frame x 2
