HedayaAli/Self-balancing-/sbr-design/Our project/blue-wheel-for-hobby-robotics/blue_wheel_with_adapter.SLDASM

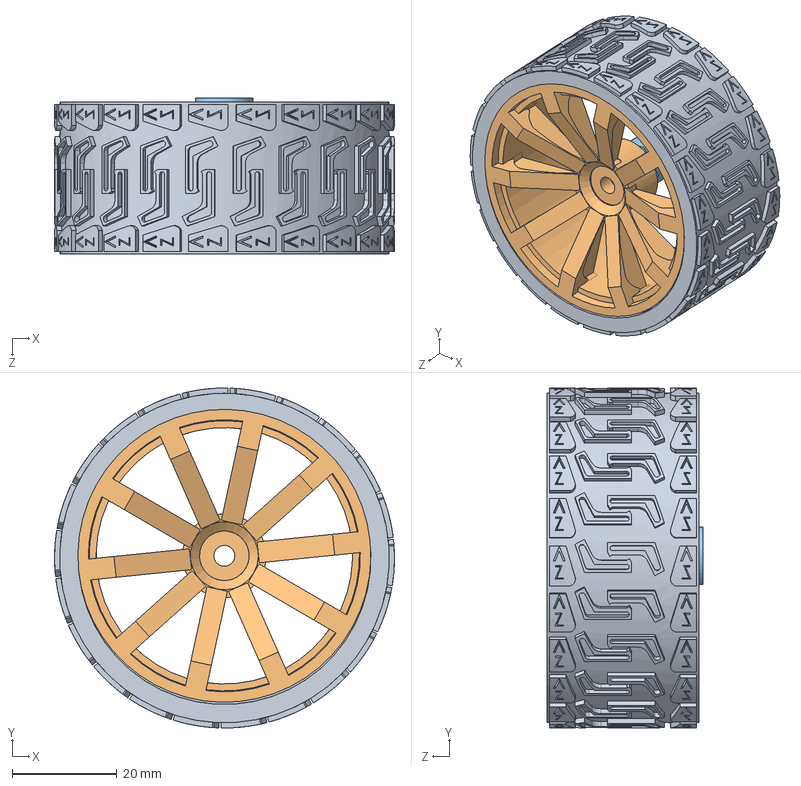
[picture p85: CAD file, 2017-12-02]
sbr-design/Our project/blue-wheel-for-hobby-robotics/blue_wheel_with_adapter.SLDASM
65.0 x 65.0 x 29.8 mm
65mm tire
blue_wheel_frame
motor_adapter
