HedayaAli/Self-balancing-/sbr-design/Our project/Assem1-1.SLDASM

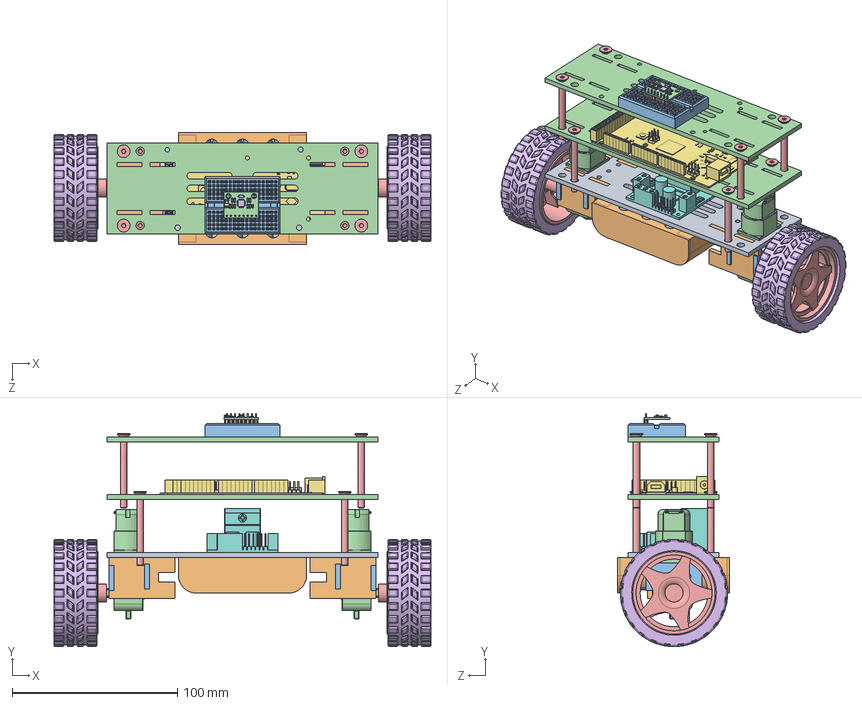
[picture p86: CAD file, 2017-12-02]
sbr-design/Our project/Assem1-1.SLDASM
228.4 x 141.2 x 67.8 mm
Base_top
mot_backDouble x 4
motor_sideHinge x 4
DC Motor_Yellow Gear box x 2
Rueda x 2
Llanta x 2
ArduinoMega2560
l298n1
New4P_TRAY
MiniBreadboard
Base
pin header x 8
sensor chip
S2NH chip
Resistor small x 6
Resistor small black x 4
Small LED
Resistor black
Base_toptop x 2
socket countersunk head screw_am x 8
