HedayaAli/Self-balancing-/sbr-design/Our project/balance-robot-1.snapshot.4/Assem2.SLDASM

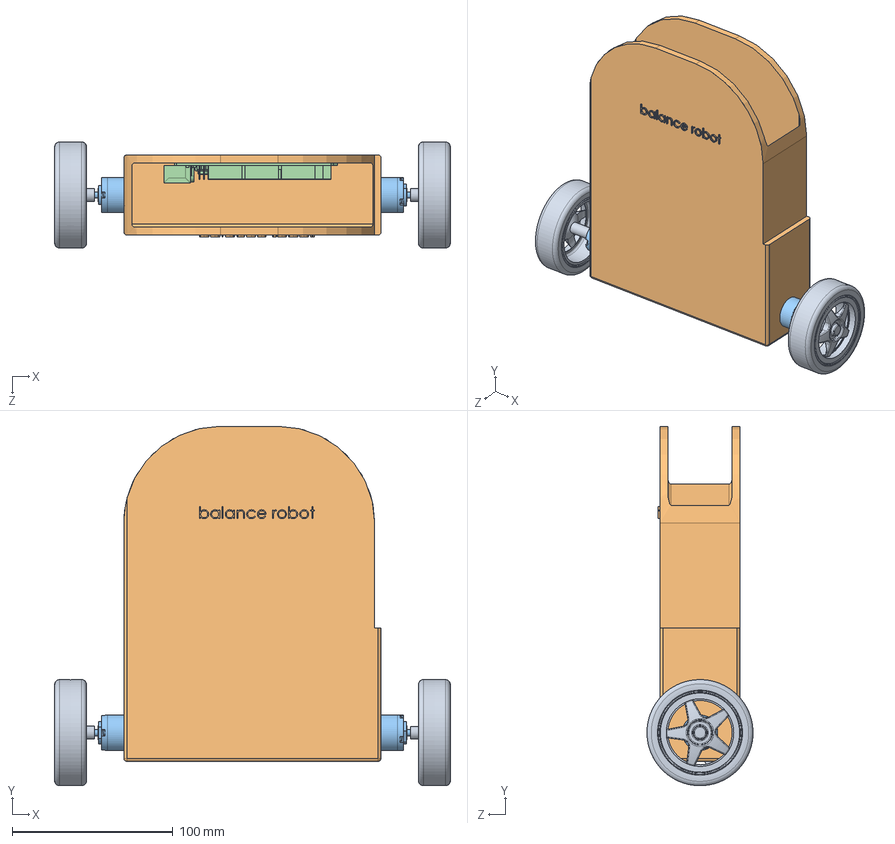
[picture p87: CAD file, 2017-11-30]
sbr-design/Our project/balance-robot-1.snapshot.4/Assem2.SLDASM
246.2 x 223.5 x 66.0 mm
Rueda 01 x 2
Robotzone Gearmotor 195RPM - 12VDC - ServoCity #638256 x 2
ArduinoMega
