HedayaAli/Self-balancing-/New Motor with base/MotorHolder.SLDASM

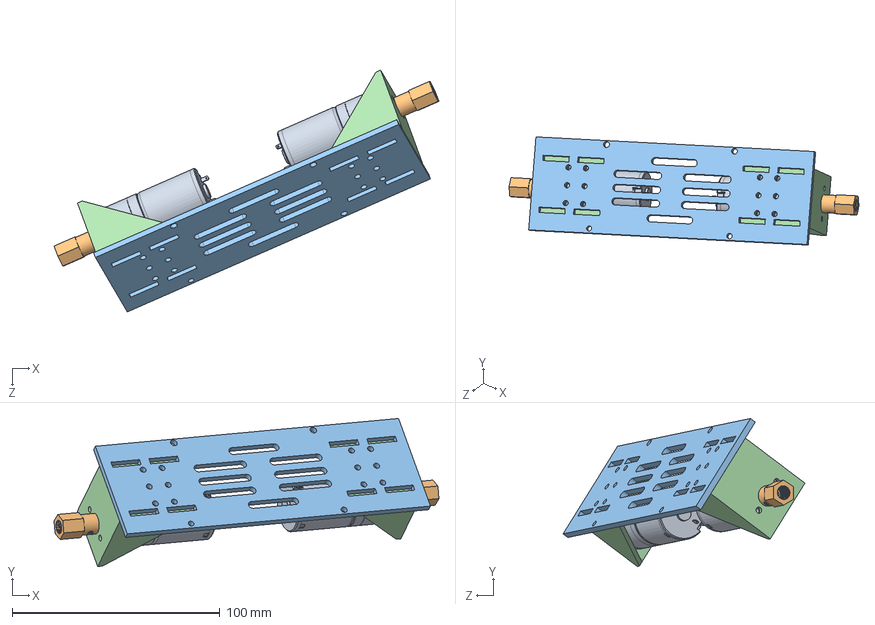
[picture p88: CAD file, 2017-12-01]
New Motor with base/MotorHolder.SLDASM
185.4 x 71.3 x 116.5 mm
JGA25-370 12V Planetary Geared Motor x 2
Coupler x 2
Base Plate
Motor holder x 2
