HedayaAli/Self-balancing-/sbr-design/Our project/motor-driver-l298n.snapshot.1/L298n.SLDASM

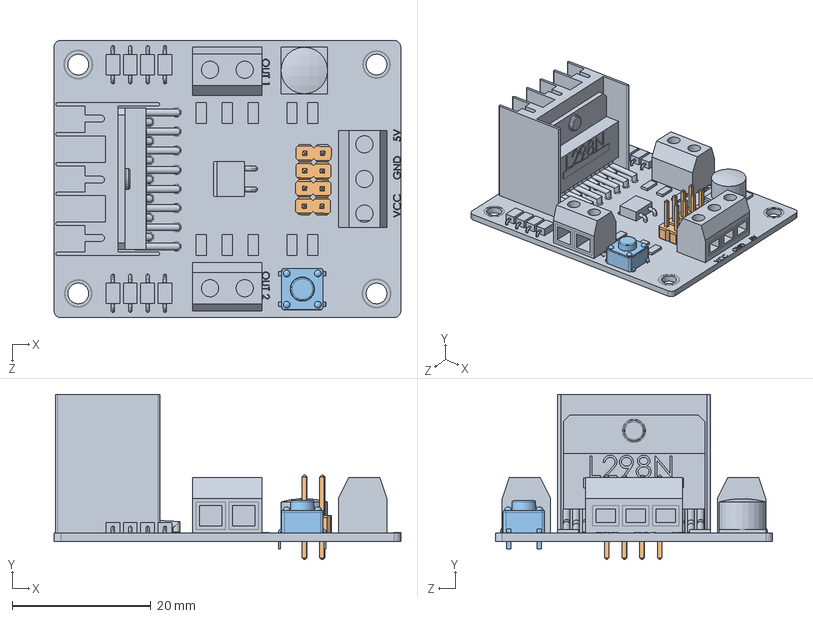
[picture p89: CAD file, 2017-11-30]
sbr-design/Our project/motor-driver-l298n.snapshot.1/L298n.SLDASM
50.0 x 23.8 x 40.0 mm
l298n
HDR2x4
Tact DIP 6x6
