HedayaAli/Self-balancing-/sbr-design/Our project/blue-wheel-for-hobby-robotics/blue_wheel_v1.SLDASM

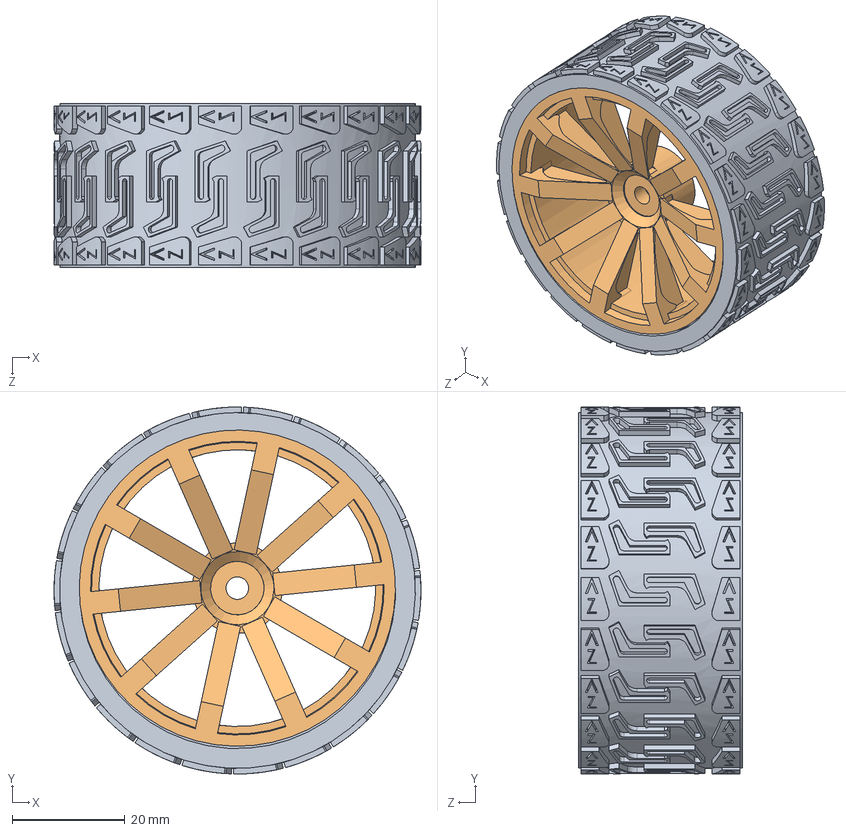
[picture p91: CAD file, 2017-12-02]
sbr-design/Our project/blue-wheel-for-hobby-robotics/blue_wheel_v1.SLDASM
65.0 x 65.0 x 29.0 mm
65mm tire
blue_wheel_frame
