HedayaAli/Self-balancing-/sbr-design/Our project/self-balancing-bot-1.snapshot.4/Assem1.SLDASM

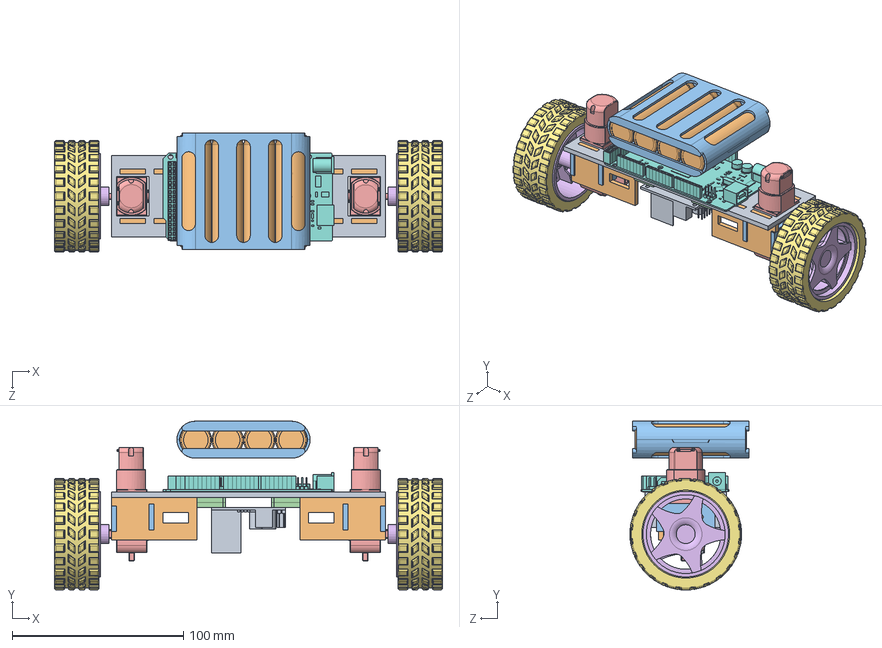
[picture p92: CAD file, 2017-11-30]
sbr-design/Our project/self-balancing-bot-1.snapshot.4/Assem1.SLDASM
226.4 x 98.4 x 69.4 mm
Base_top
mot_backDouble x 4
motor_sideHinge x 4
mot_siderback x 4
DC Motor_Yellow Gear box x 2
Rueda x 2
Llanta x 2
ArduinoMega2560
l298n1
4P_TRAY x 2
