HedayaAli/Self-balancing-/sbr-design/Our project/self-balancing-robot-2.snapshot.2/Self Balancing robot/Assem_self_balancing.SLDASM

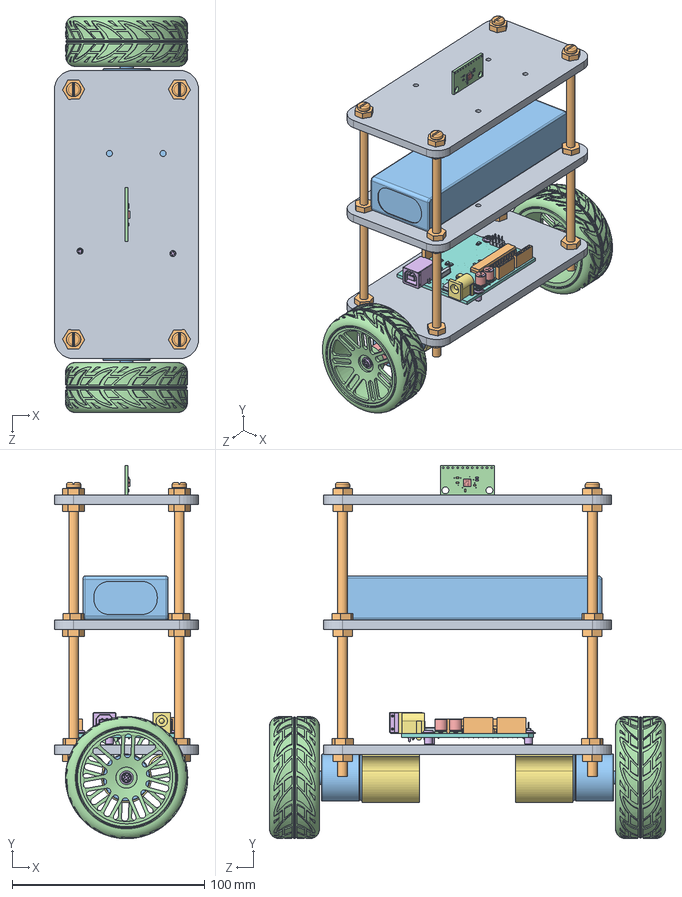
[picture p93: CAD file, 2017-11-30]
sbr-design/Our project/self-balancing-robot-2.snapshot.2/Self Balancing robot/Assem_self_balancing.SLDASM
75.0 x 194.2 x 206.0 mm
chasis boad x 3
rod x 4
Dc_motor x 2
wheel x 2
wheel_connector x 2
Wheet_nut x 6
clamp x 2
PCB_Final
Header Vertical 2.54mm Pitch2
IC DIP 28
User Library-QFN32 (FTDI)_Anschl_X_FCsse_1
User Library-QFN32 (FTDI)_K_X_F6rper_1
User Library-QFN32 (FTDI)_Beschriftung_1
User Library-67068-0000-molex
User Library-dc range - dc connector[4840_2201]
LED 1206 x 4
XTAL Small
Stackable Female Pin Header x 4
User Library-ALU-D8_Pins_1 x 2
User Library-ALU-D8_Fuss_1 x 2
User Library-ALU-D8_K_X_F6rper_1 x 2
User Library-ALU-D8_Beschriftung_1 x 2
User Library-SOIC-8_SOIC-8_Body_1
User Library-SOIC-8_SOIC-8_Pins_1
SO 369A
Nut x 24
Turnigy_2650mAh_4S__nano_tech_Lipo_Battery
MPU-9150_(CI_Board)
MPU-9150_(Chip)
MPU-9150_(0603_SMD1) x 2
MPU-9150_(0603_SMD2) x 4
