HedayaAli/Self-balancing-/New Motor with base/Coupler.SLDPRT

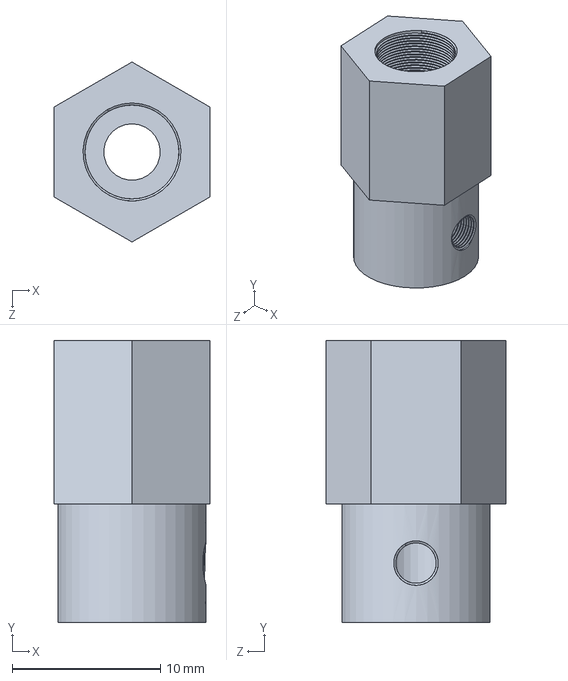
[picture p94: CAD file, 2017-12-02]
New Motor with base/Coupler.SLDPRT
10.5 x 19.0 x 12.1 mm
