HedayaAli/Self-balancing-/sbr-design/mot_backDouble.DXF

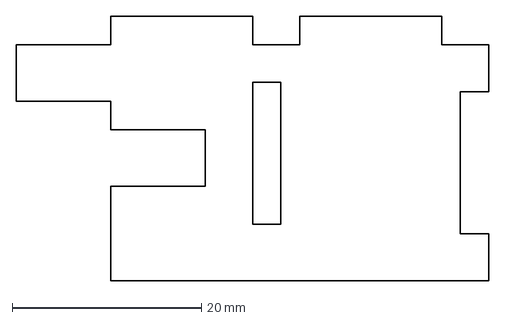
[picture p95: CAD file, 2017-11-30]
sbr-design/mot_backDouble.DXF
50.0 x 28.0 mm
