HedayaAli/Self-balancing-/sbr-design/Our project/4p-18650-cartridge.snapshot.1/New4P_TRAY.sldprt

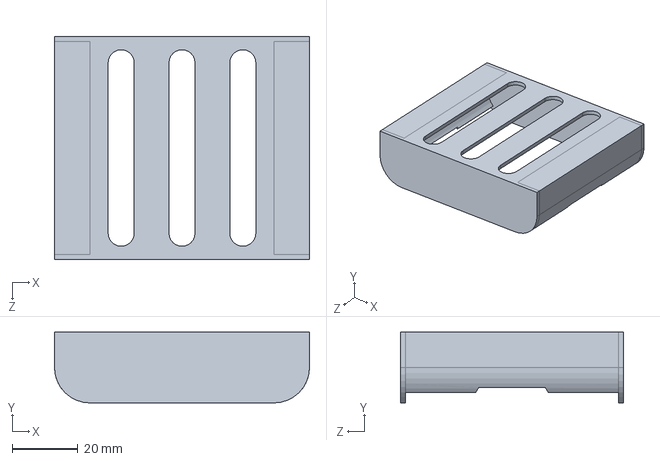
[picture p96: CAD file, 2017-12-02]
sbr-design/Our project/4p-18650-cartridge.snapshot.1/New4P_TRAY.sldprt
77.7 x 21.6 x 67.8 mm
