HedayaAli/Self-balancing-/sbr-design/Our project/arduino-mega-2560-3.snapshot.1/ArduinoMega2560/ArduinoMega2560.SLDPRT

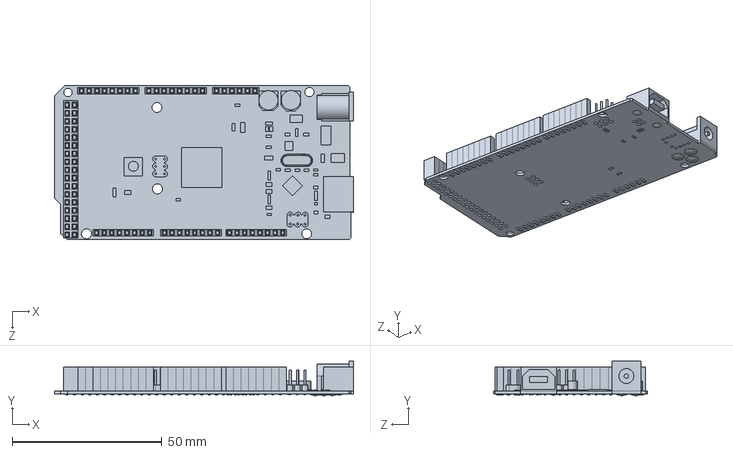
[picture p97: CAD file, 2017-11-30]
sbr-design/Our project/arduino-mega-2560-3.snapshot.1/ArduinoMega2560/ArduinoMega2560.SLDPRT
100.0 x 11.6 x 51.6 mm
