HedayaAli/Self-balancing-/sbr-design/Our project/balance-robot-1.snapshot.4/Part1.SLDPRT

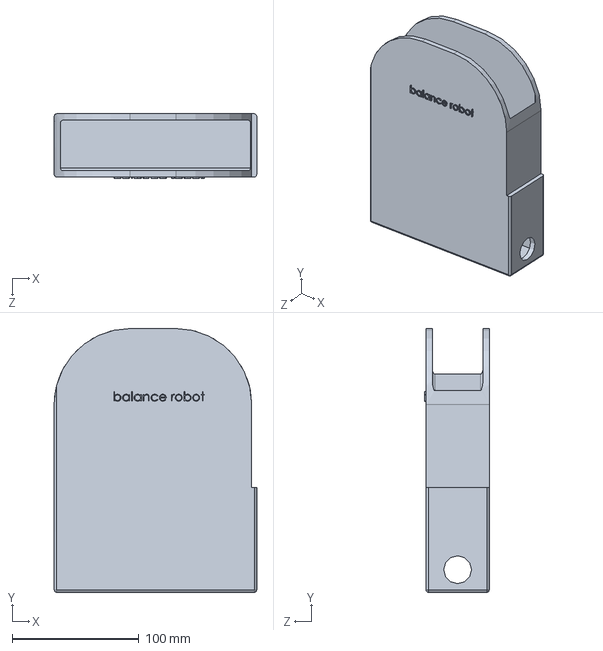
[picture p98: CAD file, 2017-11-30]
sbr-design/Our project/balance-robot-1.snapshot.4/Part1.SLDPRT
160.0 x 208.5 x 51.0 mm
