HedayaAli/Self-balancing-/sbr-design/Our project/dc-motor-with-gearbox-1.snapshot.1/DC Motor_Yellow Gear box.SLDPRT

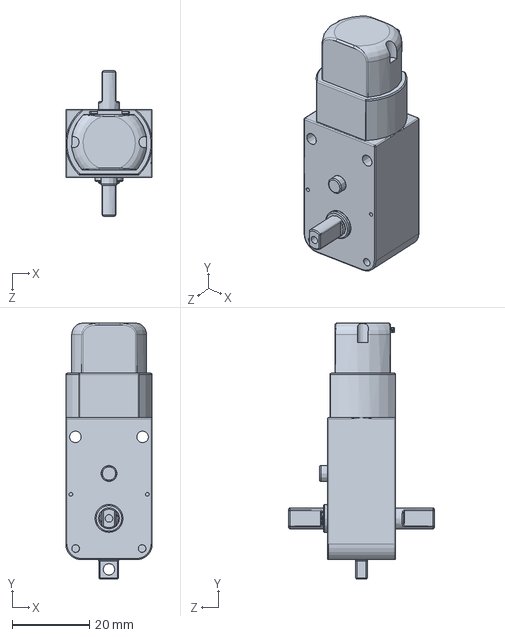
[picture p99: CAD file, 2017-11-30]
sbr-design/Our project/dc-motor-with-gearbox-1.snapshot.1/DC Motor_Yellow Gear box.SLDPRT
22.4 x 66.3 x 37.7 mm
