HedayaAli/Self-balancing-/sbr-design/Our project/driver-l298n-1.snapshot.5/L298N/L298N_V2.SLDPRT

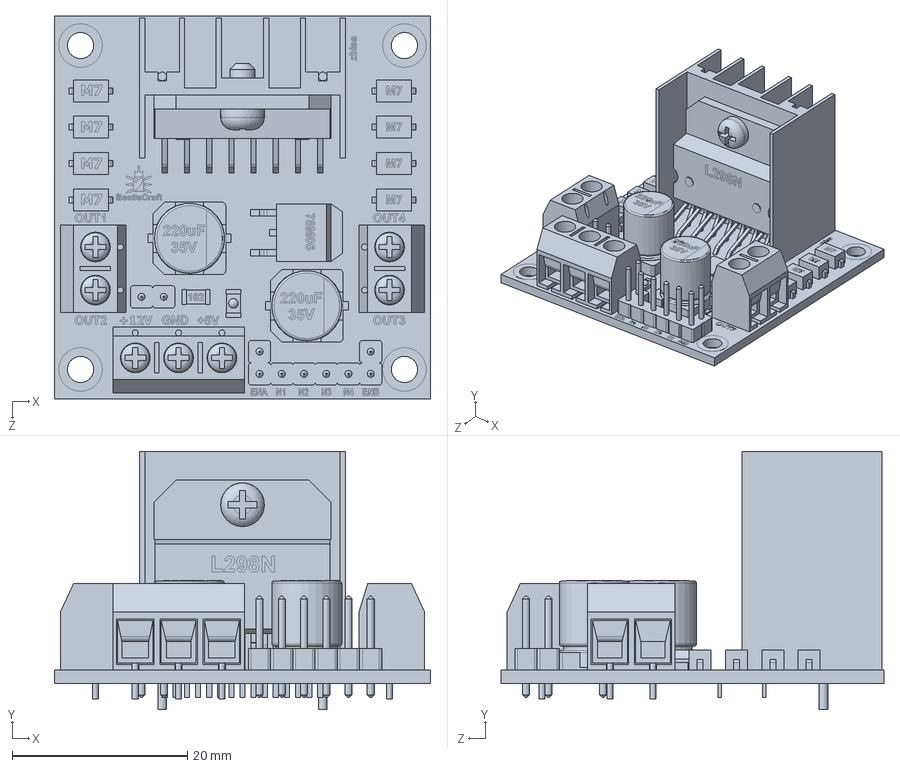
[picture p100: CAD file, 2017-11-30]
sbr-design/Our project/driver-l298n-1.snapshot.5/L298N/L298N_V2.SLDPRT
43.0 x 29.5 x 43.8 mm
