HedayaAli/Self-balancing-/sbr-design/Our project/l298n-5.snapshot.2/l298n1.SLDPRT

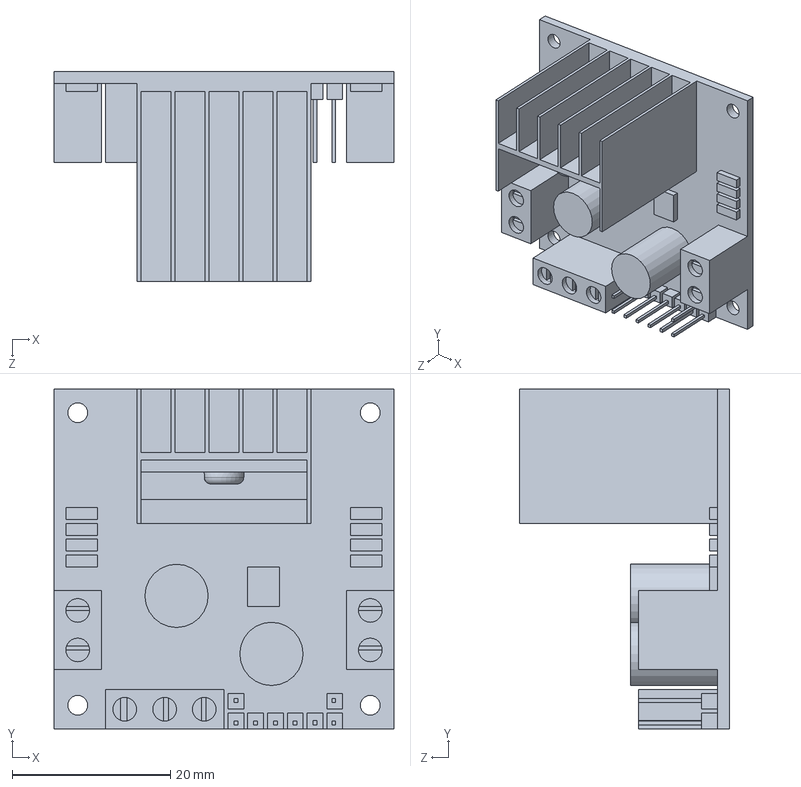
[picture p101: CAD file, 2017-11-30]
sbr-design/Our project/l298n-5.snapshot.2/l298n1.SLDPRT
43.0 x 43.0 x 26.5 mm
