HedayaAli/Self-balancing-/sbr-design/Our project/mini-breadboard.snapshot.2/MiniBreadboard.SLDPRT

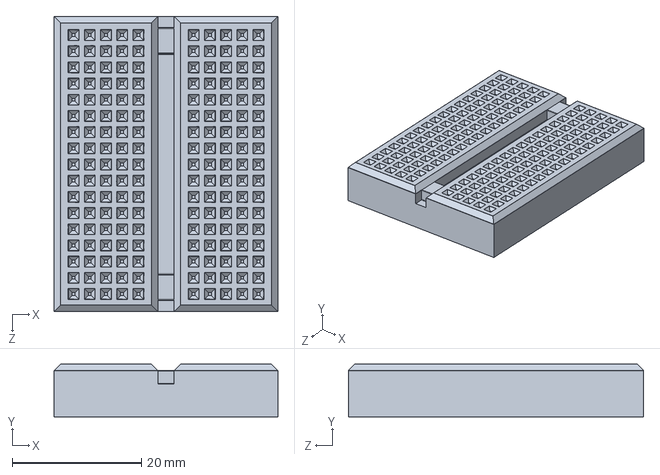
[picture p102: CAD file, 2017-11-30]
sbr-design/Our project/mini-breadboard.snapshot.2/MiniBreadboard.SLDPRT
34.6 x 8.15 x 45.6 mm
