HedayaAli/Self-balancing-/sbr-design/Our project/mini_breadboard_170_holes-1.snapshot.3/Mini_breadboard_170_holes.FCStd

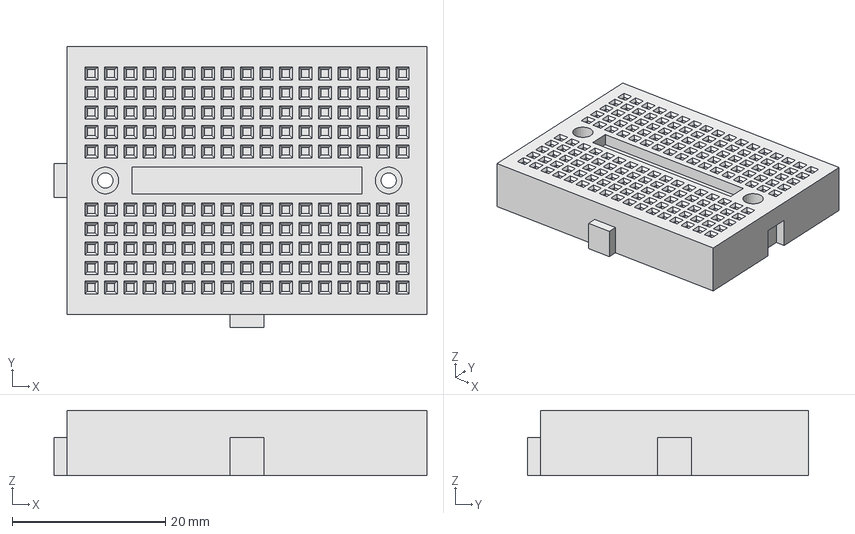
[picture p103: CAD file, 2017-11-30]
sbr-design/Our project/mini_breadboard_170_holes-1.snapshot.3/Mini_breadboard_170_holes.FCStd
48.7 x 36.7 x 8.50 mm
