HedayaAli/Self-balancing-/sbr-design/Our project/mpu-6050-imu-sensor-1.snapshot.5/sensor chip.SLDPRT

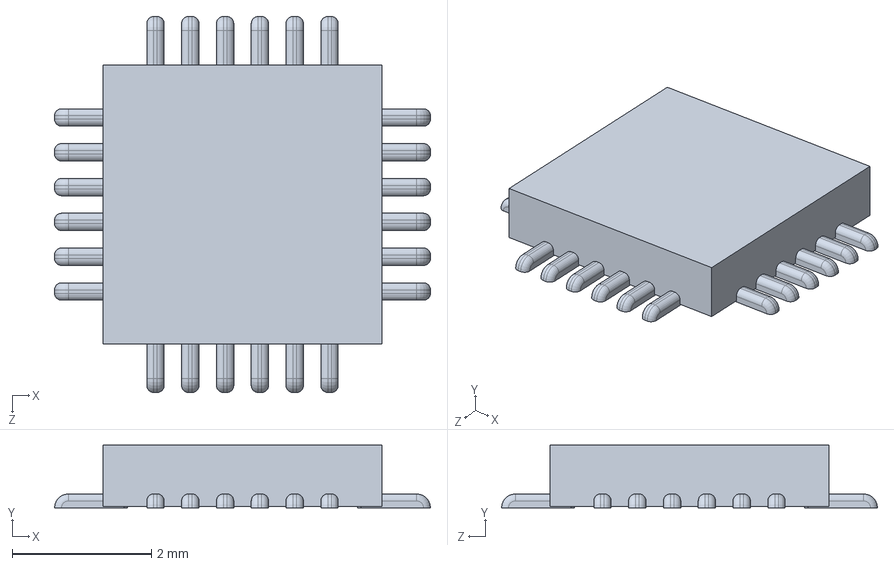
[picture p104: CAD file, 2017-11-30]
sbr-design/Our project/mpu-6050-imu-sensor-1.snapshot.5/sensor chip.SLDPRT
5.40 x 0.9 x 5.40 mm
