HedayaAli/Self-balancing-/sbr-design/Our project/robotdyn-mega-r3-1.snapshot.1/RobotDyn Mega R3/Pin Header - Double Row - Straight - 2.54 - 3x2.SLDPRT

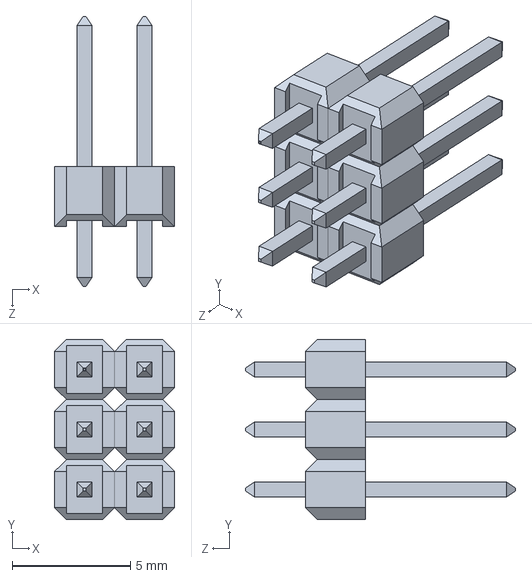
[picture p105: CAD file, 2017-11-30]
sbr-design/Our project/robotdyn-mega-r3-1.snapshot.1/RobotDyn Mega R3/Pin Header - Double Row - Straight - 2.54 - 3x2.SLDPRT
5.08 x 7.62 x 11.4 mm
