HedayaAli/Self-balancing-/sbr-design/Our project/self-balancing-bot-1.snapshot.4/Base_new_robot.DXF

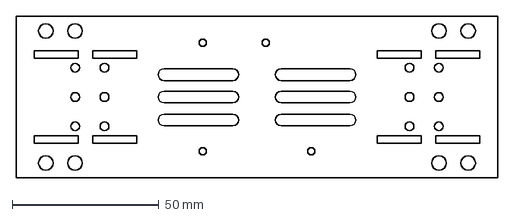
[picture p106: CAD file, 2017-12-02]
sbr-design/Our project/self-balancing-bot-1.snapshot.4/Base_new_robot.DXF
164.0 x 55.0 mm
