HedayaAli/Self-balancing-/sbr-design/Our project/self-balancing-robot-2.snapshot.2/Self Balancing robot/rod.SLDPRT

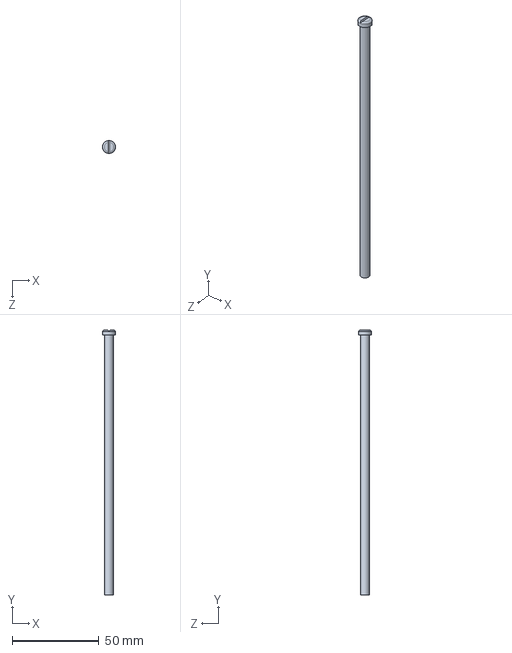
[picture p107: CAD file, 2017-11-30]
sbr-design/Our project/self-balancing-robot-2.snapshot.2/Self Balancing robot/rod.SLDPRT
7.50 x 153.0 x 7.50 mm
