HedayaAli/Self-balancing-/New Motor with base/L HOLDER DC MOTOR.SLDPRT

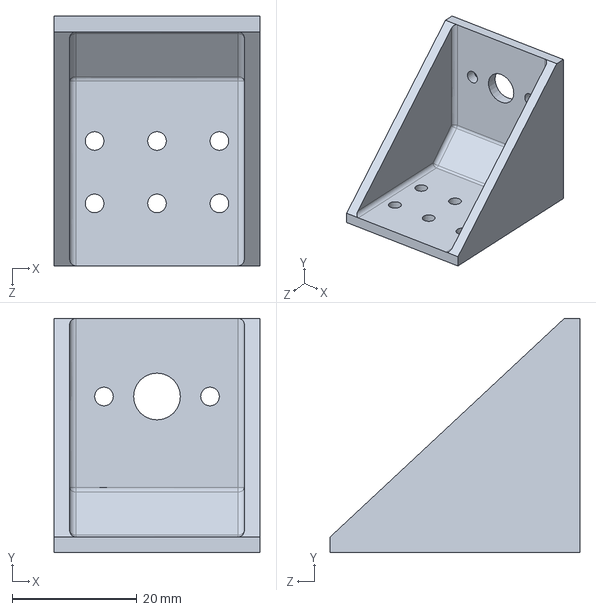
[picture p108: CAD file, 2017-12-02]
New Motor with base/L HOLDER DC MOTOR.SLDPRT
33.0 x 37.5 x 40.0 mm
