HedayaAli/Self-balancing-/sbr-design/motor_sideHinge.DXF

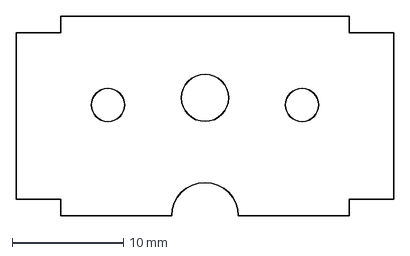
[picture p109: CAD file, 2017-11-30]
sbr-design/motor_sideHinge.DXF
34.0 x 18.0 mm
