HedayaAli/Self-balancing-/sbr-design/Our project/blue-wheel-for-hobby-robotics/blue_wheel_frame.SLDPRT

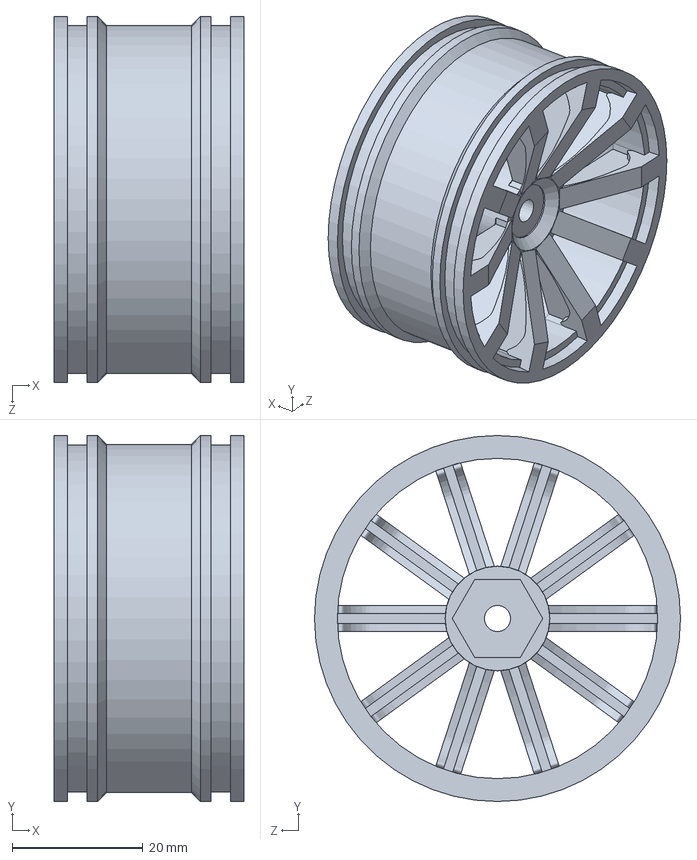
[picture p110: CAD file, 2017-12-02]
sbr-design/Our project/blue-wheel-for-hobby-robotics/blue_wheel_frame.SLDPRT
29.0 x 56.0 x 56.0 mm
