HedayaAli/Self-balancing-/sbr-design/Our project/driver-l298n-1.snapshot.5/L298N/Soporte_L298N.SLDPRT

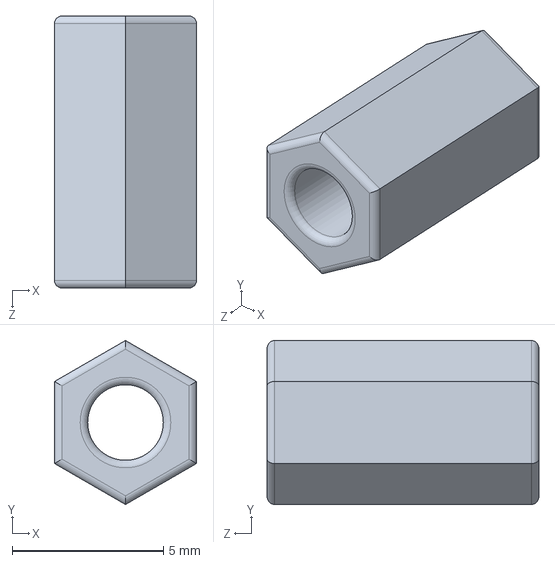
[picture p111: CAD file, 2017-11-30]
sbr-design/Our project/driver-l298n-1.snapshot.5/L298N/Soporte_L298N.SLDPRT
4.70 x 5.43 x 9.00 mm
