HedayaAli/Self-balancing-/sbr-design/Our project/mpu-6050-imu-sensor-1.snapshot.5/Resistor small.SLDPRT

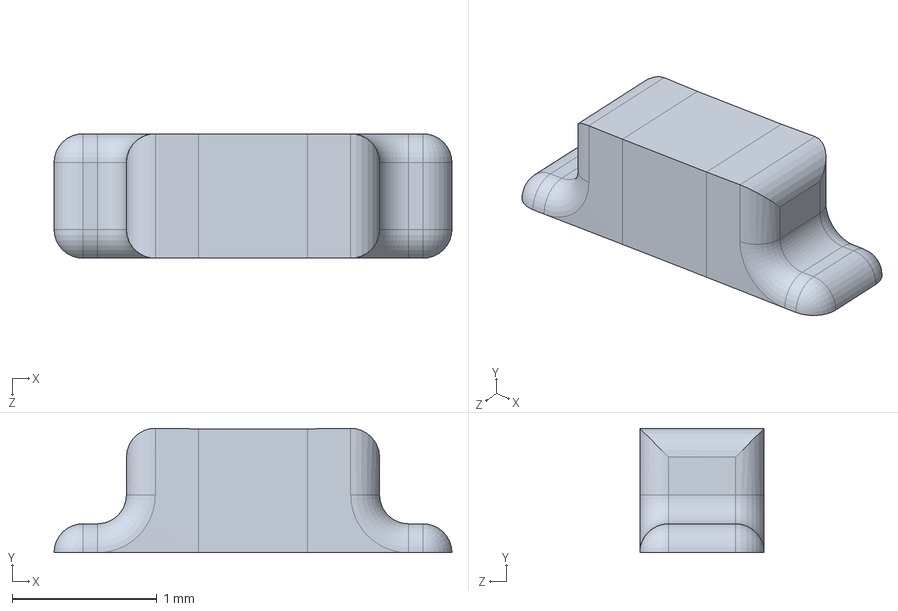
[picture p112: CAD file, 2017-11-30]
sbr-design/Our project/mpu-6050-imu-sensor-1.snapshot.5/Resistor small.SLDPRT
2.75 x 0.86 x 0.86 mm
