HedayaAli/Self-balancing-/sbr-design/Our project/self-balancing-bot-1.snapshot.4/Base_top.SLDPRT

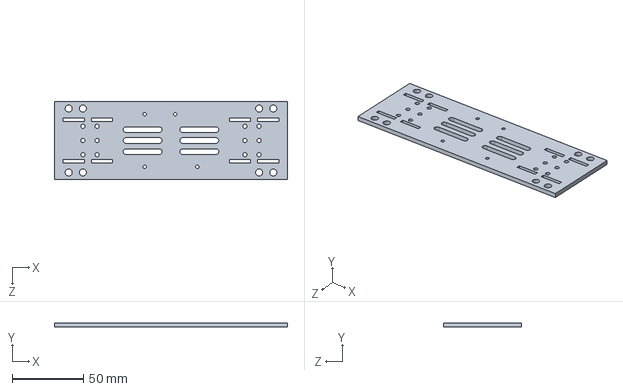
[picture p114: CAD file, 2017-12-02]
sbr-design/Our project/self-balancing-bot-1.snapshot.4/Base_top.SLDPRT
164.0 x 3.00 x 55.0 mm
