HedayaAli/Self-balancing-/sbr-design/Base_top.DXF

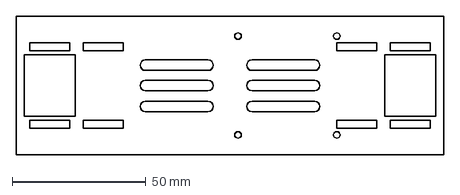
[picture p115: CAD file, 2017-11-30]
sbr-design/Base_top.DXF
160.0 x 52.0 mm
