HedayaAli/Self-balancing-/sbr-design/Our project/blue-wheel-for-hobby-robotics/motor_adapter.SLDPRT

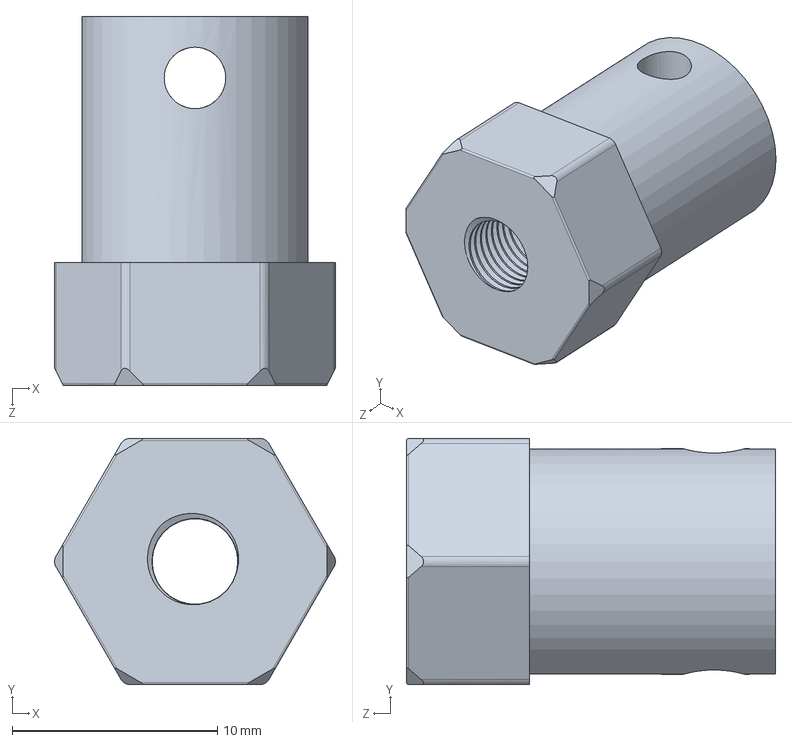
[picture p116: CAD file, 2017-12-02]
sbr-design/Our project/blue-wheel-for-hobby-robotics/motor_adapter.SLDPRT
13.7 x 12.0 x 18.0 mm
