HedayaAli/Self-balancing-/sbr-design/Our project/mpu-6050-imu-sensor-1.snapshot.5/Resistor black.SLDPRT

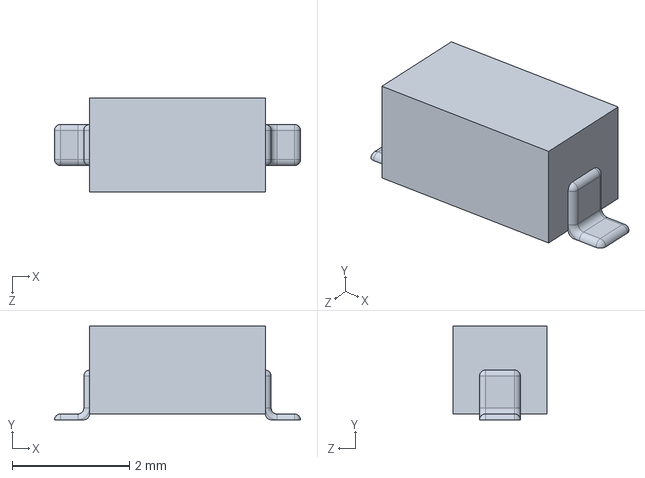
[picture p117: CAD file, 2017-11-30]
sbr-design/Our project/mpu-6050-imu-sensor-1.snapshot.5/Resistor black.SLDPRT
4.20 x 1.60 x 1.60 mm
