HedayaAli/Self-balancing-/sbr-design/Our project/robotdyn-mega-r3-1.snapshot.1/RobotDyn Mega R3/Capacitor - Aluminum Electrolytic - 47uF - 35V - Kemet - EEV476M035(1)9GAA.SLDPRT

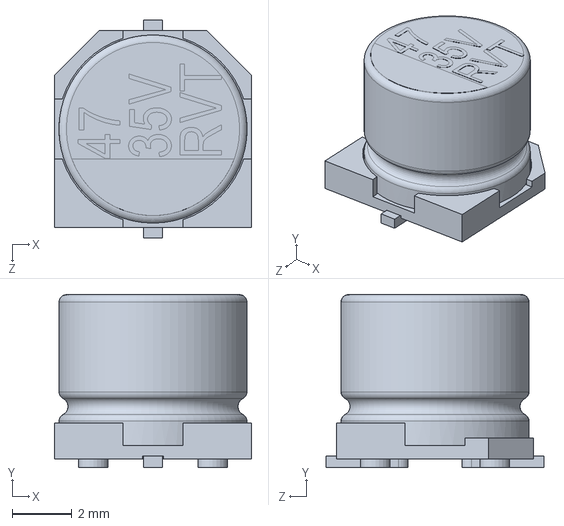
[picture p118: CAD file, 2017-11-30]
sbr-design/Our project/robotdyn-mega-r3-1.snapshot.1/RobotDyn Mega R3/Capacitor - Aluminum Electrolytic - 47uF - 35V - Kemet - EEV476M035(1)9GAA.SLDPRT
6.60 x 5.81 x 7.30 mm
