HedayaAli/Self-balancing-/sbr-design/Our project/self-balancing-bot-1.snapshot.4/motor_sideHinge.SLDPRT

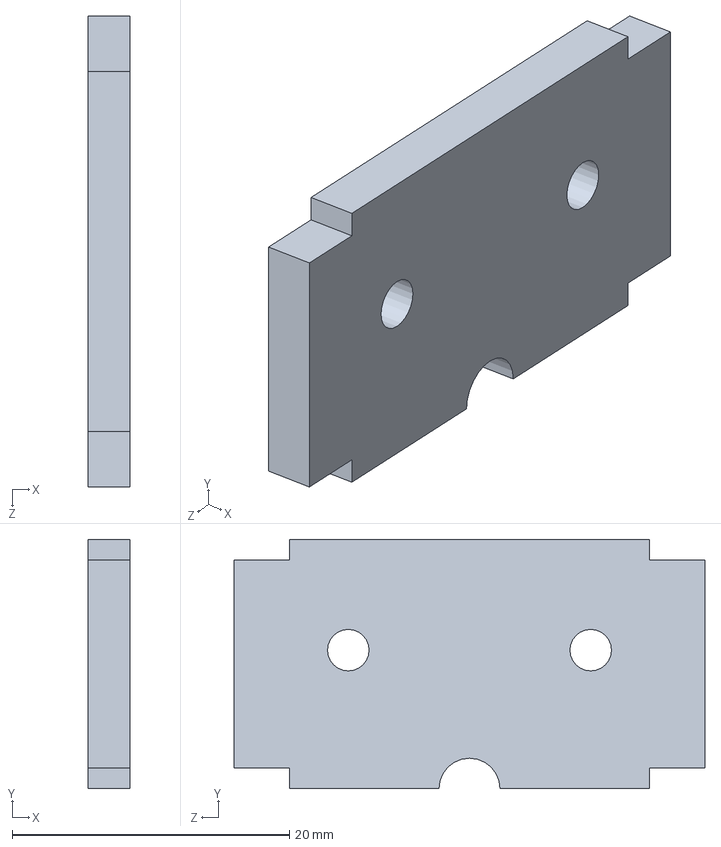
[picture p119: CAD file, 2017-11-30]
sbr-design/Our project/self-balancing-bot-1.snapshot.4/motor_sideHinge.SLDPRT
3.00 x 18.0 x 34.0 mm
