HedayaAli/Self-balancing-/New Motor with base/Base Plate.SLDPRT

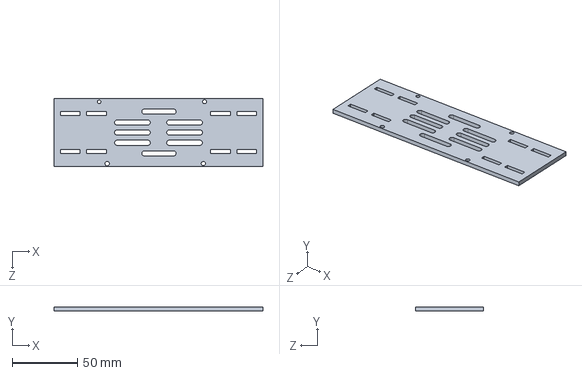
[picture p120: CAD file, 2017-12-01]
New Motor with base/Base Plate.SLDPRT
160.0 x 3.00 x 52.0 mm
