HedayaAli/Self-balancing-/sbr-design/mot_siderback.DXF

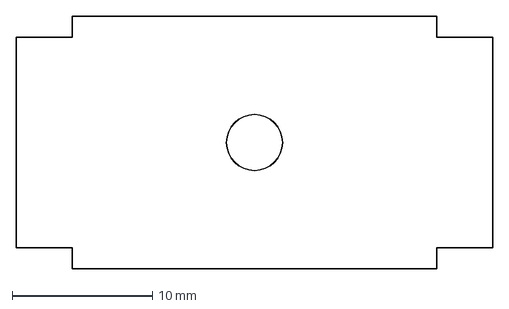
[picture p121: CAD file, 2017-11-30]
sbr-design/mot_siderback.DXF
34.0 x 18.0 mm
