HedayaAli/Self-balancing-/sbr-design/Our project/4p-18650-cartridge.snapshot.1/4P.STEP

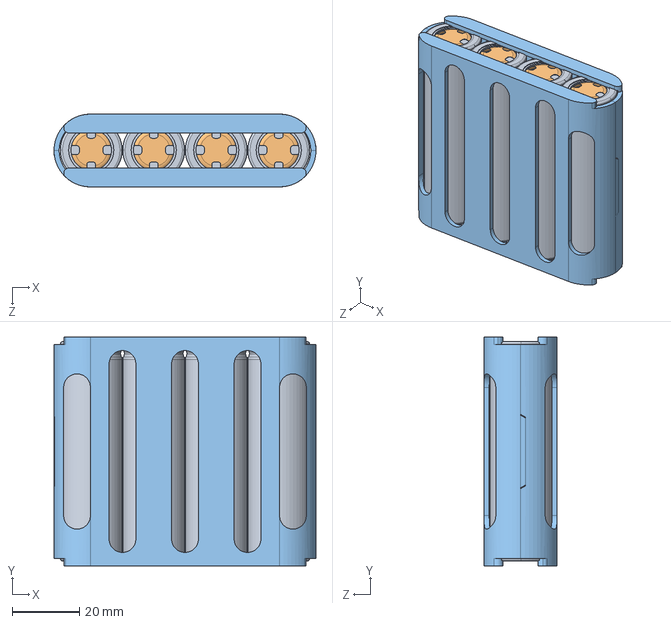
[picture p122: CAD file, 2017-11-30]
sbr-design/Our project/4p-18650-cartridge.snapshot.1/4P.STEP
77.7 x 67.8 x 21.6 mm
4P_TRAY x 2
