HedayaAli/Self-balancing-/sbr-design/Our project/mpu-6050-imu-sensor-1.snapshot.5/S2NH chip.SLDPRT

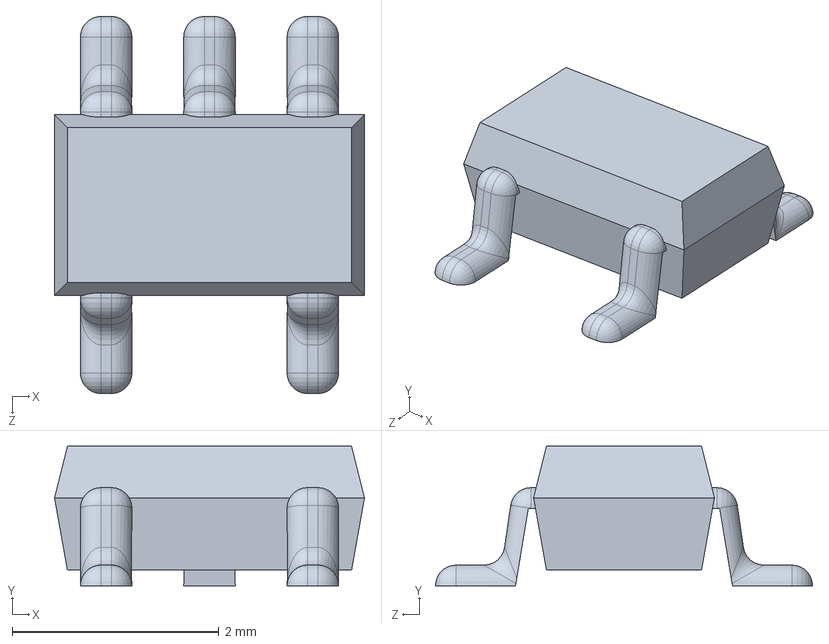
[picture p123: CAD file, 2017-11-30]
sbr-design/Our project/mpu-6050-imu-sensor-1.snapshot.5/S2NH chip.SLDPRT
3.00 x 1.35 x 3.65 mm
