HedayaAli/Self-balancing-/sbr-design/Our project/robotdyn-mega-r3-1.snapshot.1/RobotDyn Mega R3/Micro USB Connector - SMD.SLDPRT

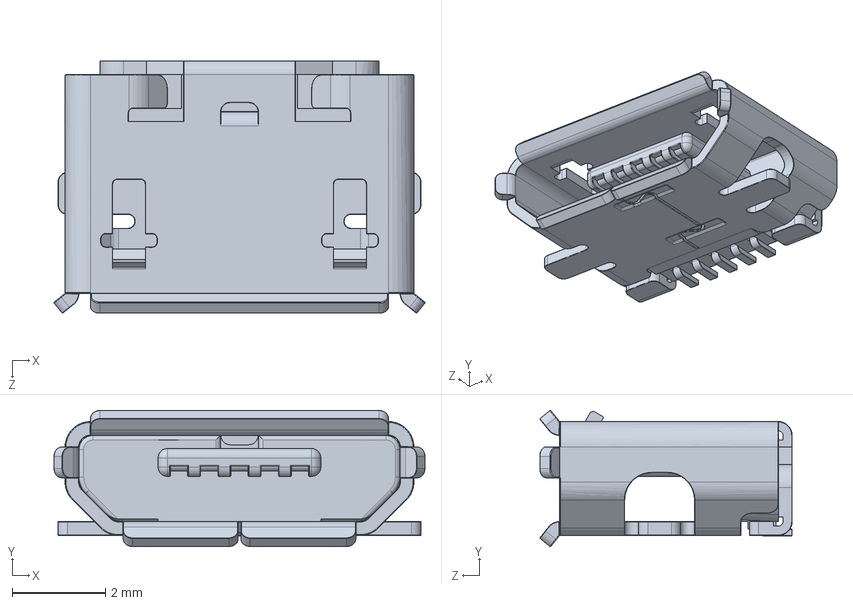
[picture p124: CAD file, 2017-11-30]
sbr-design/Our project/robotdyn-mega-r3-1.snapshot.1/RobotDyn Mega R3/Micro USB Connector - SMD.SLDPRT
7.97 x 2.92 x 5.43 mm
