HedayaAli/Self-balancing-/sbr-design/Our project/self-balancing-robot-2.snapshot.2/Self Balancing robot/wheel.SLDPRT

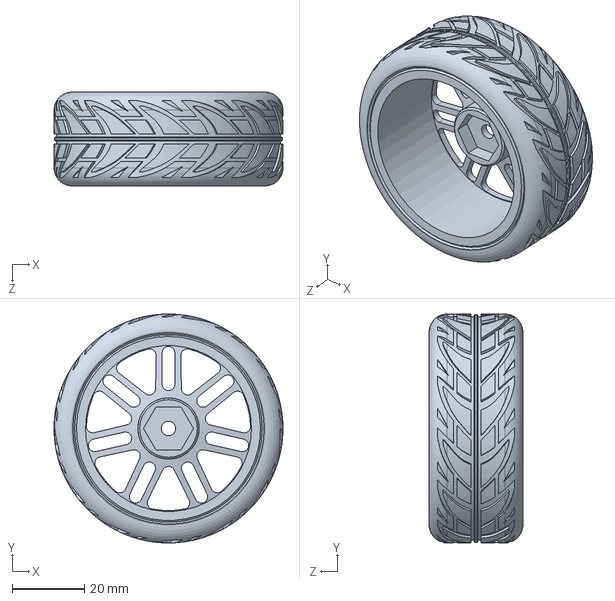
[picture p125: CAD file, 2017-11-30]
sbr-design/Our project/self-balancing-robot-2.snapshot.2/Self Balancing robot/wheel.SLDPRT
63.5 x 63.5 x 26.0 mm
