HedayaAli/Self-balancing-/sbr-design/Base_top-again.DXF

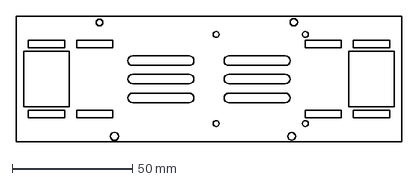
[picture p126: CAD file, 2017-11-30]
sbr-design/Base_top-again.DXF
160.0 x 52.0 mm
