HedayaAli/Self-balancing-/sbr-design/Our project/blue-wheel-for-hobby-robotics/65mm tire.SLDPRT

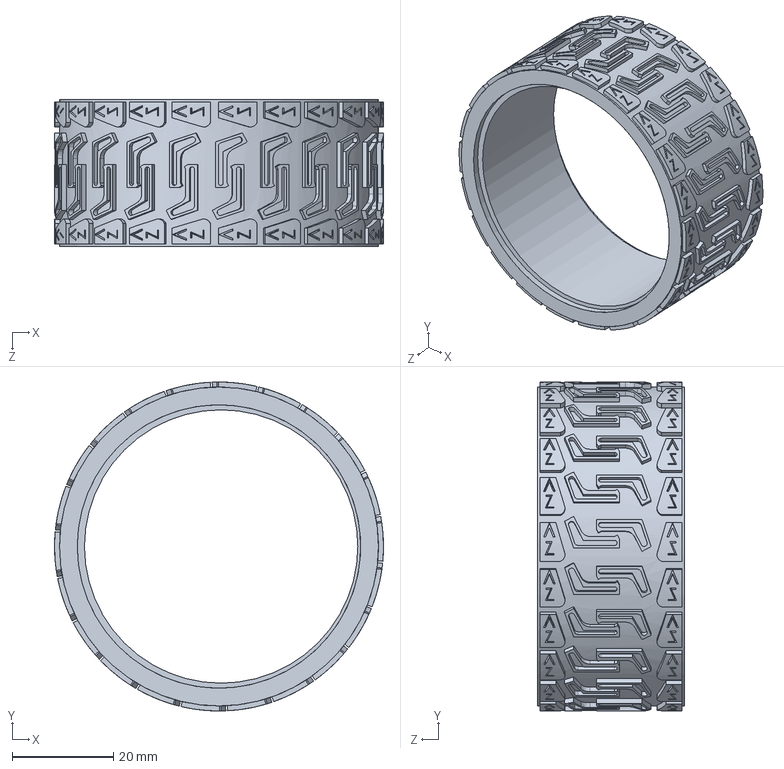
[picture p127: CAD file, 2017-12-02]
sbr-design/Our project/blue-wheel-for-hobby-robotics/65mm tire.SLDPRT
65.0 x 65.0 x 29.0 mm
