HedayaAli/Self-balancing-/sbr-design/Our project/mpu-6050-imu-sensor-1.snapshot.5/Base.SLDPRT

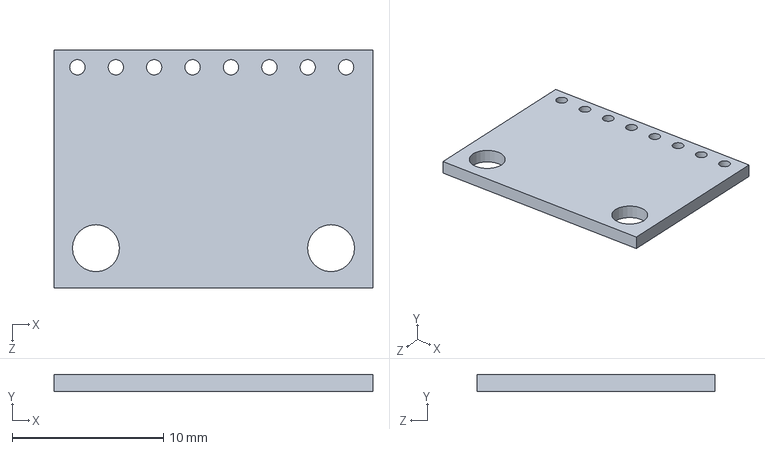
[picture p128: CAD file, 2017-11-30]
sbr-design/Our project/mpu-6050-imu-sensor-1.snapshot.5/Base.SLDPRT
21.1 x 1.14 x 15.7 mm
