HedayaAli/Self-balancing-/sbr-design/Our project/robotdyn-mega-r3-1.snapshot.1/RobotDyn Mega R3/Reset Button.SLDPRT

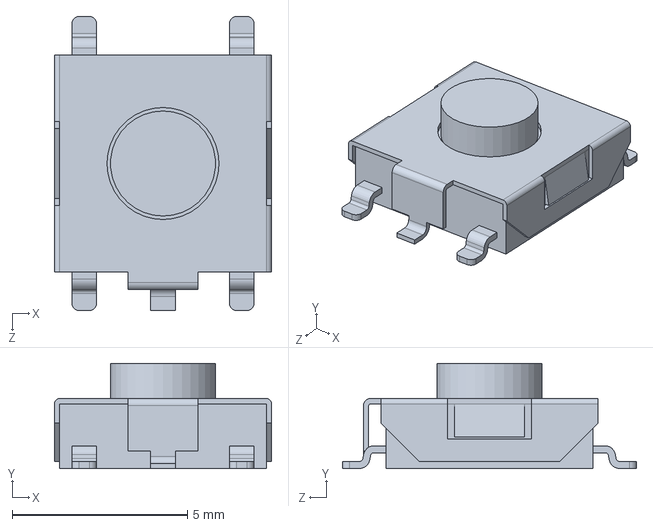
[picture p129: CAD file, 2017-11-30]
sbr-design/Our project/robotdyn-mega-r3-1.snapshot.1/RobotDyn Mega R3/Reset Button.SLDPRT
6.20 x 3.00 x 8.40 mm
