HedayaAli/Self-balancing-/sbr-design/Our project/self-balancing-bot-1.snapshot.4/Rueda.SLDPRT

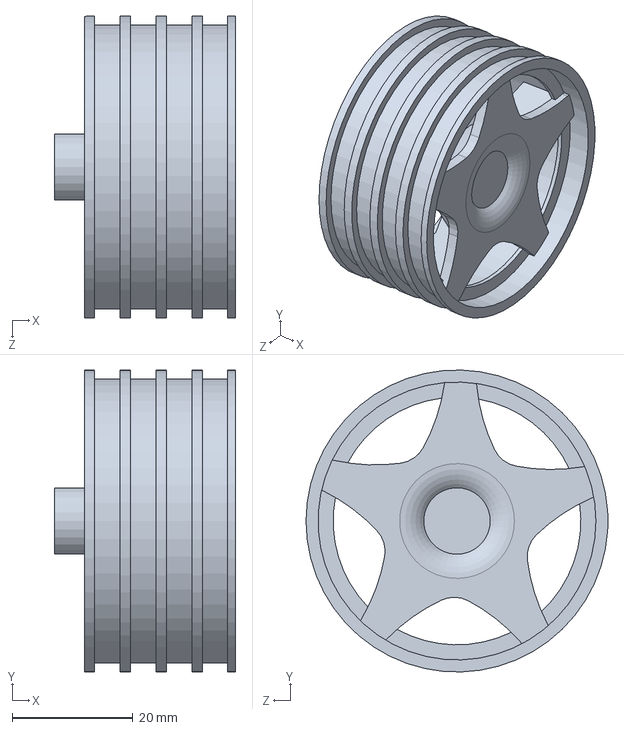
[picture p130: CAD file, 2017-11-30]
sbr-design/Our project/self-balancing-bot-1.snapshot.4/Rueda.SLDPRT
30.0 x 50.0 x 50.0 mm
