HedayaAli/Self-balancing-/sbr-design/Our project/self-balancing-robot-2.snapshot.2/Self Balancing robot/Dc_motor.SLDPRT

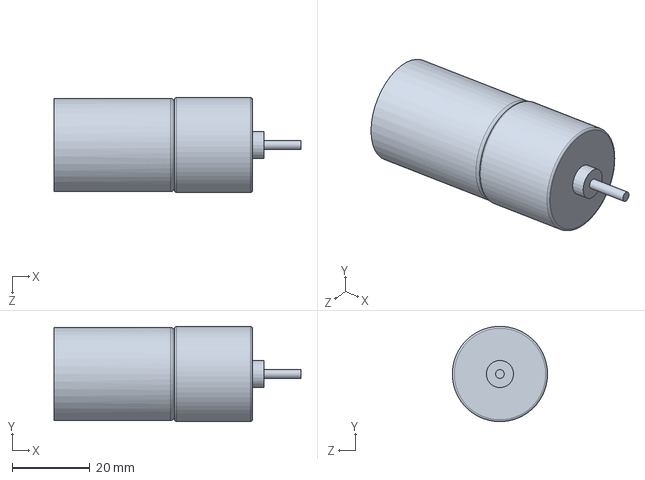
[picture p131: CAD file, 2017-11-30]
sbr-design/Our project/self-balancing-robot-2.snapshot.2/Self Balancing robot/Dc_motor.SLDPRT
63.5 x 24.5 x 24.5 mm
