HedayaAli/Self-balancing-/sbr-design/Base2.DXF

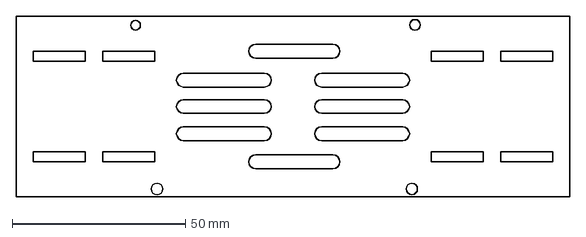
[picture p132: CAD file, 2017-11-30]
sbr-design/Base2.DXF
160.0 x 52.0 mm
