HedayaAli/Self-balancing-/sbr-design/Our project/mpu-6050-imu-sensor-1.snapshot.5/Small LED.SLDPRT

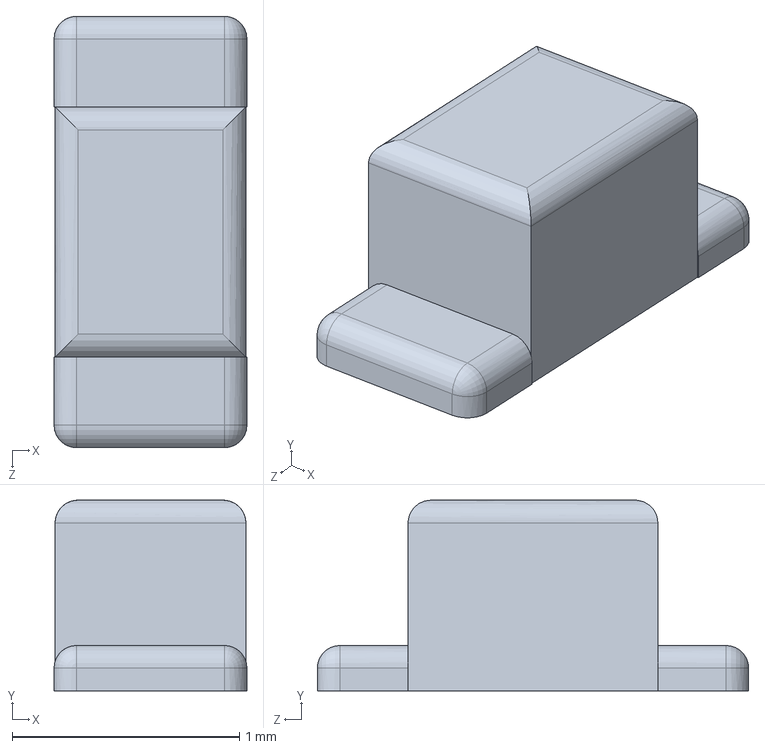
[picture p133: CAD file, 2017-11-30]
sbr-design/Our project/mpu-6050-imu-sensor-1.snapshot.5/Small LED.SLDPRT
0.85 x 0.84 x 1.90 mm
