HedayaAli/Self-balancing-/sbr-design/Our project/robotdyn-mega-r3-1.snapshot.1/RobotDyn Mega R3/Rectifier Diode - SMD - 1N4007 - M7 - DO-214AC.SLDPRT

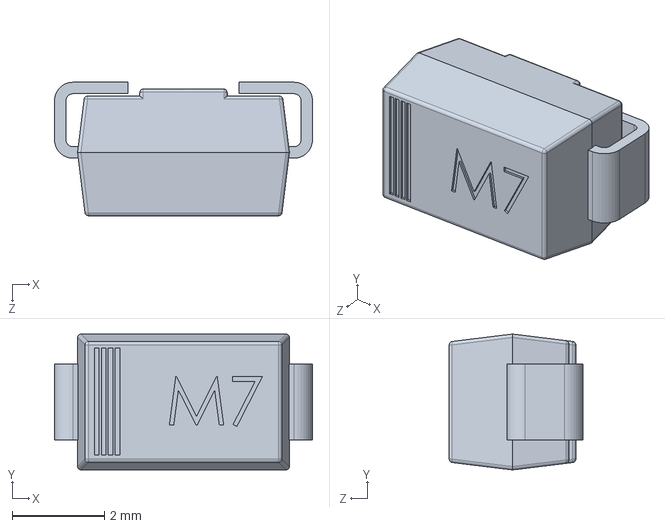
[picture p134: CAD file, 2017-11-30]
sbr-design/Our project/robotdyn-mega-r3-1.snapshot.1/RobotDyn Mega R3/Rectifier Diode - SMD - 1N4007 - M7 - DO-214AC.SLDPRT
5.60 x 2.95 x 2.90 mm
