HedayaAli/Self-balancing-/sbr-design/Our project/robotdyn-mega-r3-1.snapshot.1/RobotDyn Mega R3/Female Header - Double Row - Straight - 2.54 - 18x2.SLDPRT

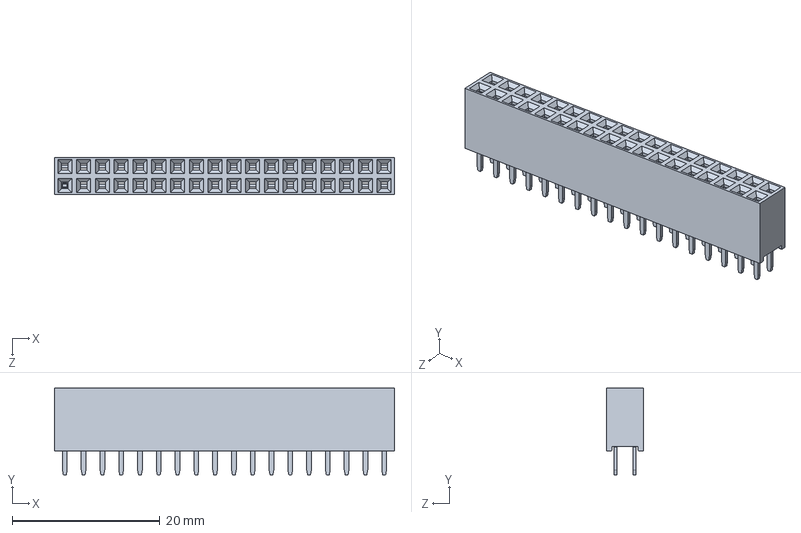
[picture p136: CAD file, 2017-11-30]
sbr-design/Our project/robotdyn-mega-r3-1.snapshot.1/RobotDyn Mega R3/Female Header - Double Row - Straight - 2.54 - 18x2.SLDPRT
46.0 x 11.7 x 5.00 mm
