HedayaAli/Self-balancing-/sbr-design/Our project/self-balancing-bot-1.snapshot.4/mot_backDouble.SLDPRT

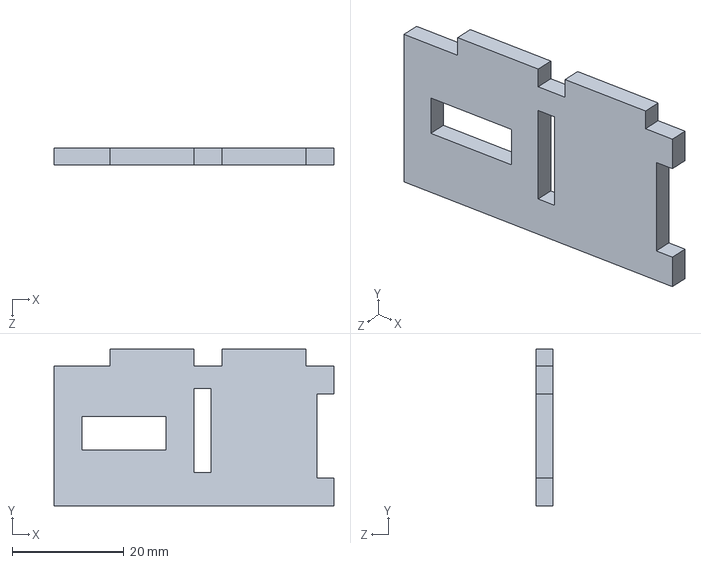
[picture p137: CAD file, 2017-11-30]
sbr-design/Our project/self-balancing-bot-1.snapshot.4/mot_backDouble.SLDPRT
50.0 x 28.0 x 3.00 mm
