HedayaAli/Self-balancing-/sbr-design/Our project/self-balancing-robot-2.snapshot.2/Self Balancing robot/chasis boad.SLDPRT

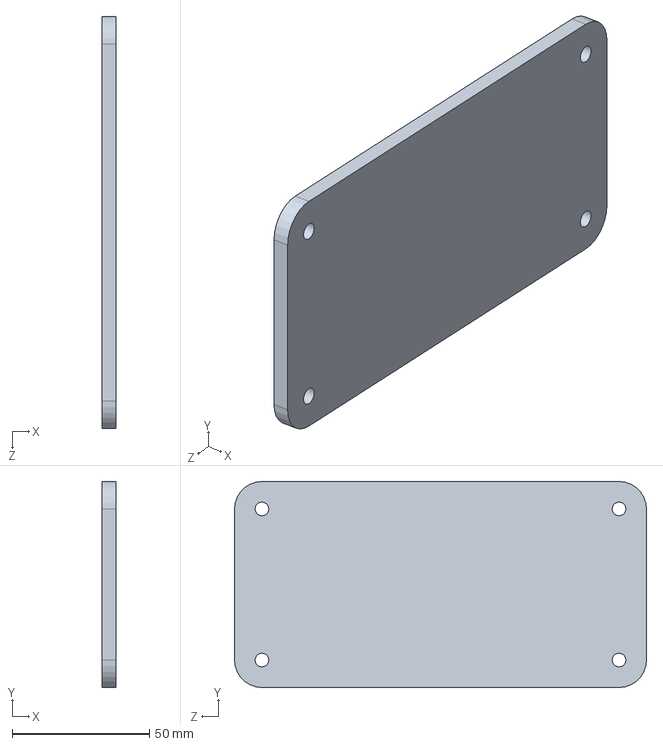
[picture p138: CAD file, 2017-11-30]
sbr-design/Our project/self-balancing-robot-2.snapshot.2/Self Balancing robot/chasis boad.SLDPRT
5.00 x 75.0 x 150.0 mm
