HedayaAli/Self-balancing-/sbr-design/Our project/mpu-6050-imu-sensor-1.snapshot.5/pin header.SLDPRT

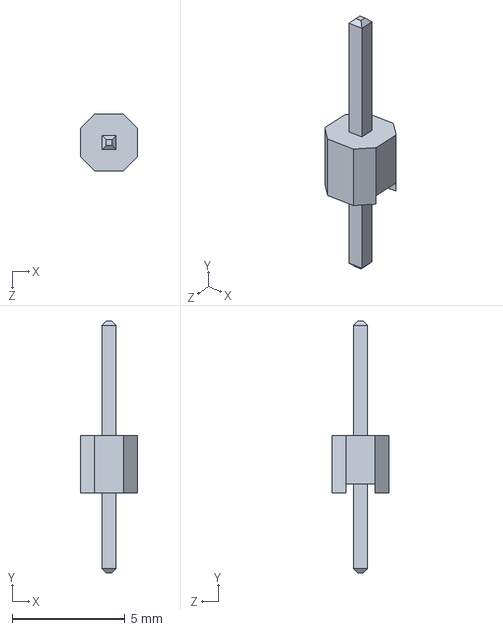
[picture p139: CAD file, 2017-11-30]
sbr-design/Our project/mpu-6050-imu-sensor-1.snapshot.5/pin header.SLDPRT
2.54 x 11.2 x 2.54 mm
