HedayaAli/Self-balancing-/sbr-design/Our project/robotdyn-mega-r3-1.snapshot.1/RobotDyn Mega R3/Crystal - XTAL - YC16.000t12 - SM49.SLDPRT

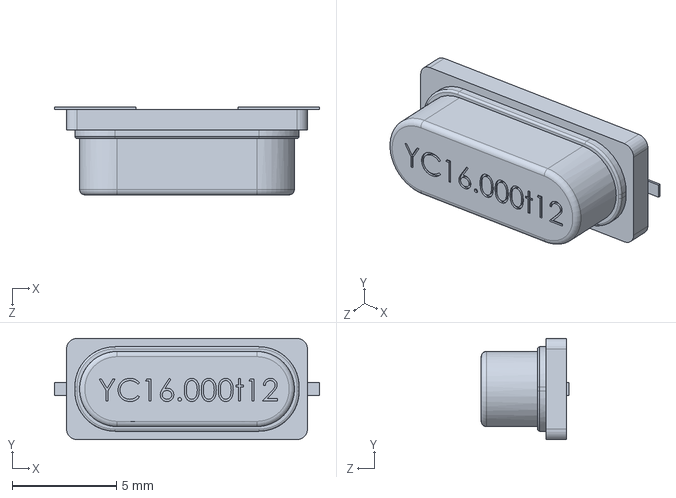
[picture p140: CAD file, 2017-11-30]
sbr-design/Our project/robotdyn-mega-r3-1.snapshot.1/RobotDyn Mega R3/Crystal - XTAL - YC16.000t12 - SM49.SLDPRT
12.7 x 4.85 x 4.20 mm
