HedayaAli/Self-balancing-/sbr-design/Our project/self-balancing-robot-2.snapshot.2/Self Balancing robot/clamp.SLDPRT

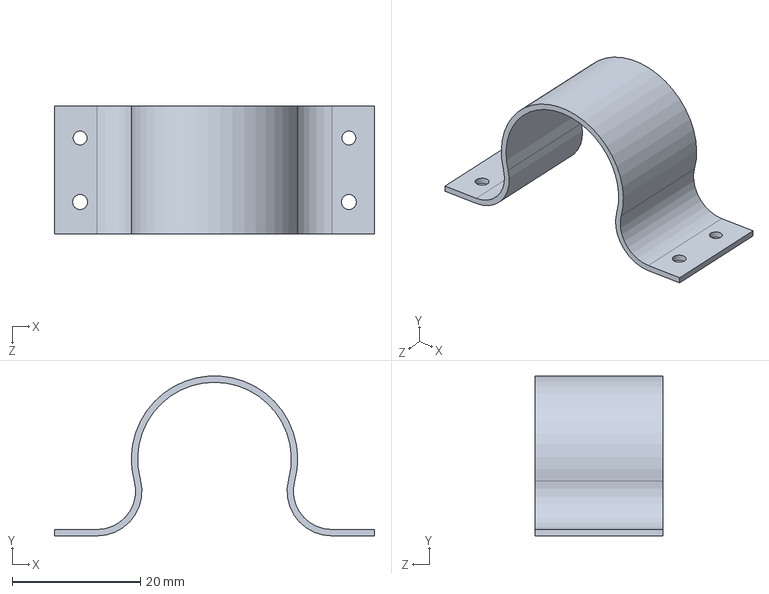
[picture p141: CAD file, 2017-11-30]
sbr-design/Our project/self-balancing-robot-2.snapshot.2/Self Balancing robot/clamp.SLDPRT
50.0 x 25.0 x 20.0 mm
