HedayaAli/Self-balancing-/sbr-design/Our project/mpu-6050-imu-sensor-1.snapshot.5/Resistor small black.SLDPRT

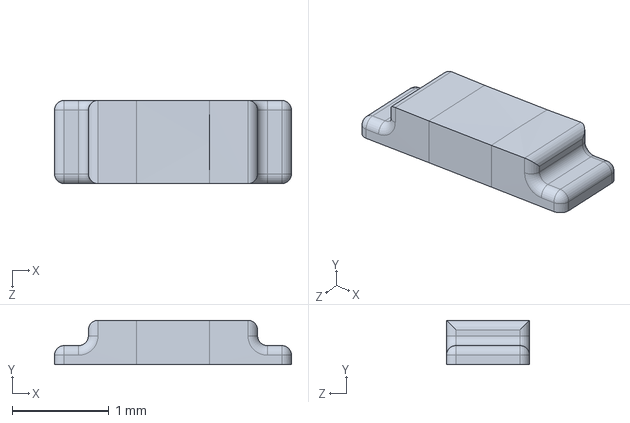
[picture p142: CAD file, 2017-11-30]
sbr-design/Our project/mpu-6050-imu-sensor-1.snapshot.5/Resistor small black.SLDPRT
2.45 x 0.46 x 0.86 mm
