HedayaAli/Self-balancing-/sbr-design/Our project/robotdyn-mega-r3-1.snapshot.1/RobotDyn Mega R3/Female Header - Single Row - Straight - 2.54 - 8x1.SLDPRT

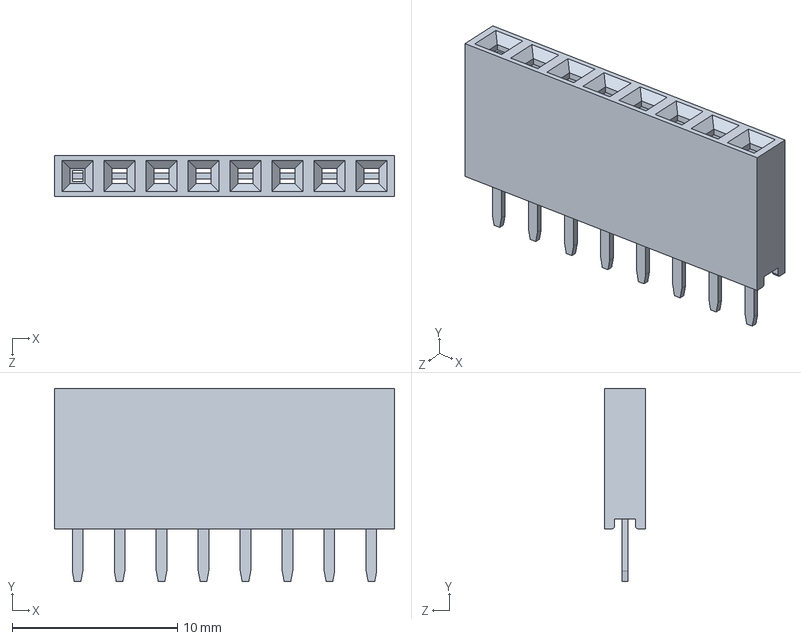
[picture p143: CAD file, 2017-11-30]
sbr-design/Our project/robotdyn-mega-r3-1.snapshot.1/RobotDyn Mega R3/Female Header - Single Row - Straight - 2.54 - 8x1.SLDPRT
20.6 x 11.7 x 2.50 mm
