HedayaAli/Self-balancing-/sbr-design/Our project/self-balancing-bot-1.snapshot.4/Plate.SLDPRT

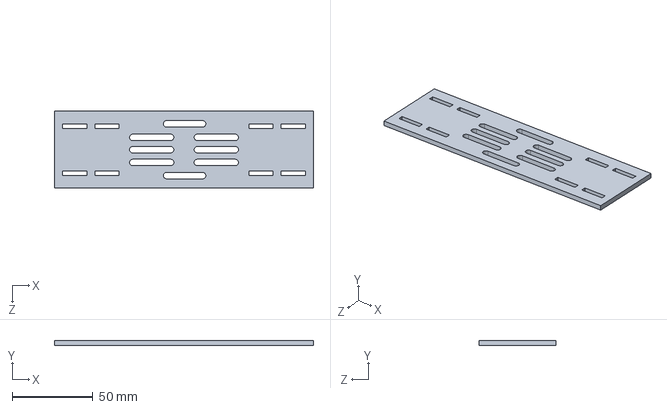
[picture p144: CAD file, 2017-11-30]
sbr-design/Our project/self-balancing-bot-1.snapshot.4/Plate.SLDPRT
160.0 x 3.00 x 47.5 mm
