HedayaAli/Self-balancing-/sbr-design/Our project/robotdyn-mega-r3-1.snapshot.1/RobotDyn Mega R3/Atmel - Atmega 2560 - TQFP100.SLDPRT

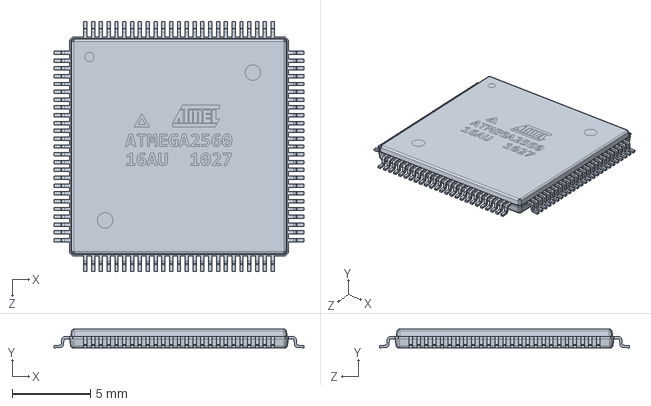
[picture p145: CAD file, 2017-11-30]
sbr-design/Our project/robotdyn-mega-r3-1.snapshot.1/RobotDyn Mega R3/Atmel - Atmega 2560 - TQFP100.SLDPRT
16.0 x 1.20 x 16.0 mm
