HedayaAli/Self-balancing-/sbr-design/Our project/self-balancing-bot-1.snapshot.4/Llanta.SLDPRT

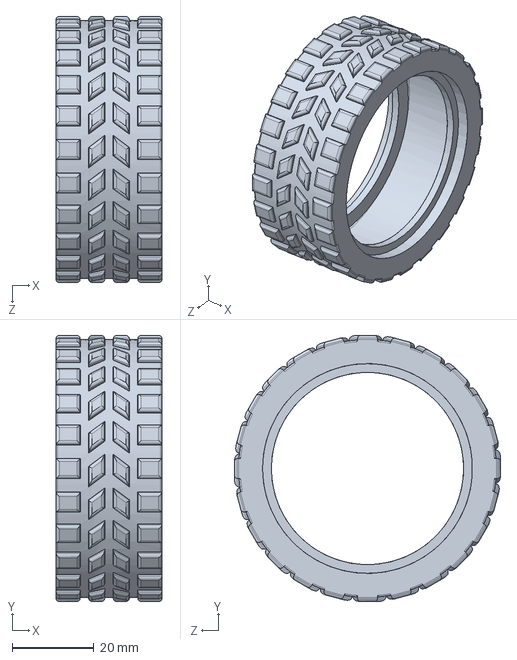
[picture p146: CAD file, 2017-11-30]
sbr-design/Our project/self-balancing-bot-1.snapshot.4/Llanta.SLDPRT
26.0 x 65.0 x 65.0 mm
