HedayaAli/Self-balancing-/sbr-design/Our project/robotdyn-mega-r3-1.snapshot.1/RobotDyn Mega R3/Voltage Regulator - AMS1117 - SOT-223.SLDPRT

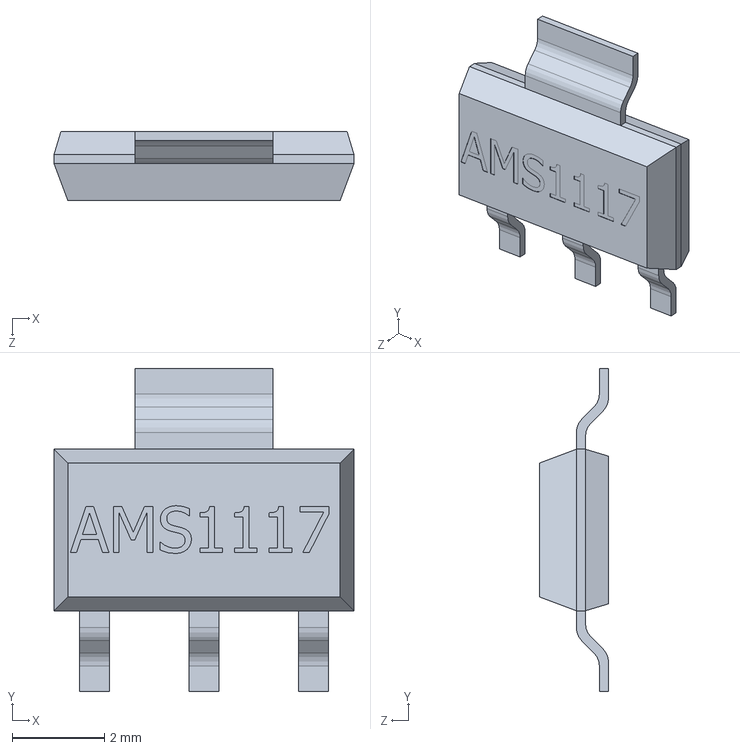
[picture p147: CAD file, 2017-11-30]
sbr-design/Our project/robotdyn-mega-r3-1.snapshot.1/RobotDyn Mega R3/Voltage Regulator - AMS1117 - SOT-223.SLDPRT
6.50 x 7.00 x 1.50 mm
