HedayaAli/Self-balancing-/sbr-design/Our project/robotdyn-mega-r3-1.snapshot.1/RobotDyn Mega R3/CH340G - SO-16.SLDPRT

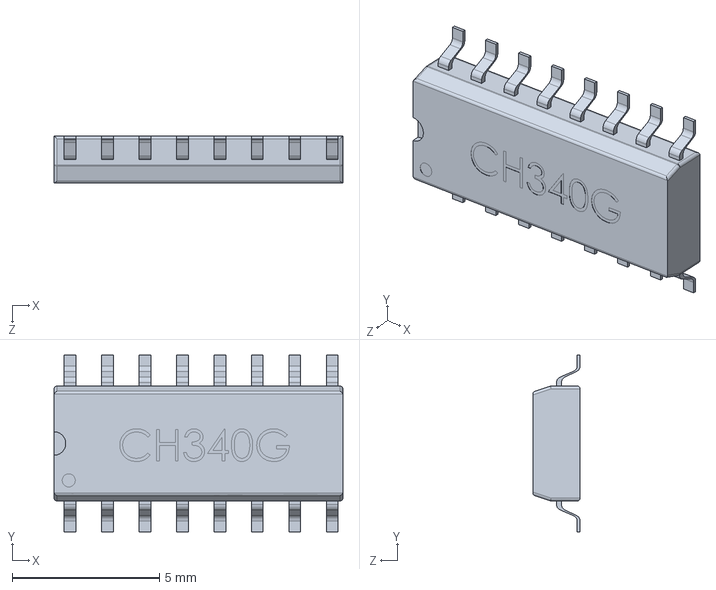
[picture p148: CAD file, 2017-11-30]
sbr-design/Our project/robotdyn-mega-r3-1.snapshot.1/RobotDyn Mega R3/CH340G - SO-16.SLDPRT
9.80 x 6.00 x 1.60 mm
