HedayaAli/Self-balancing-/sbr-design/Our project/robotdyn-mega-r3-1.snapshot.1/RobotDyn Mega R3/RobotDyn Mega R3 - PCB.SLDPRT

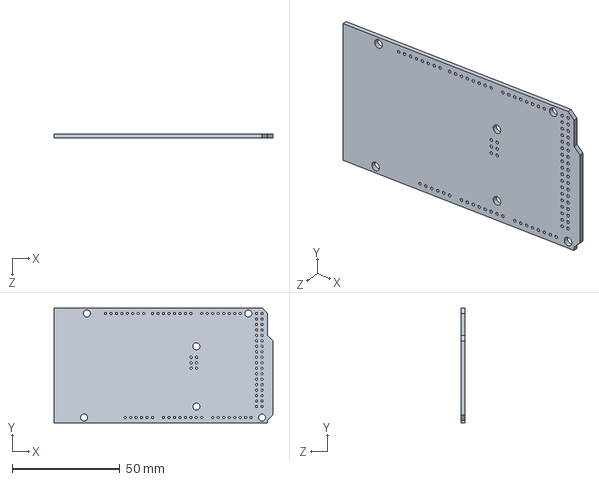
[picture p149: CAD file, 2017-11-30]
sbr-design/Our project/robotdyn-mega-r3-1.snapshot.1/RobotDyn Mega R3/RobotDyn Mega R3 - PCB.SLDPRT
101.6 x 53.3 x 1.70 mm
