HedayaAli/Self-balancing-/sbr-design/Our project/robotdyn-mega-r3-1.snapshot.1/RobotDyn Mega R3/DC Power Jack - 5.5mm x 2.1mm.SLDPRT

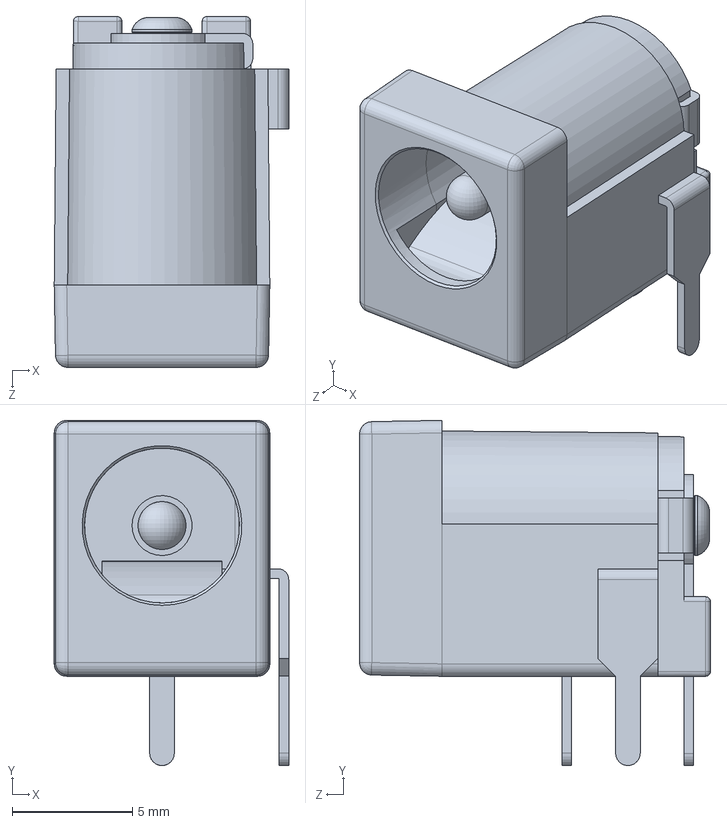
[picture p150: CAD file, 2017-11-30]
sbr-design/Our project/robotdyn-mega-r3-1.snapshot.1/RobotDyn Mega R3/DC Power Jack - 5.5mm x 2.1mm.SLDPRT
9.77 x 14.4 x 14.6 mm
