HedayaAli/Self-balancing-/(list of files, cad)

Other CAD files:
sbr-design/Our project/motor-driver-l298n.snapshot.1/Tact DIP 6x6.sldprt
sbr-design/Our project/4p-18650-cartridge.snapshot.1/4P_TRAY.sldprt
sbr-design/Our project/mini_breadboard_170_holes-1.snapshot.3/Mini_breadboard_170_pts.stl
sbr-design/Our project/motor-driver-l298n.snapshot.1/HDR2x4.sldprt
sbr-design/Our project/self-balancing-bot-1.snapshot.4/mot_siderback.SLDPRT
sbr-design/Our project/self-balancing-bot-1.snapshot.4/Base_toptop.SLDPRT
sbr-design/Our project/robotdyn-mega-r3-1.snapshot.1/RobotDyn Mega R3/Crystal - XTAL - 12.000 - SM49.SLDPRT
New Motor with base/Motor holder.SLDPRT
sbr-design/Our project/4p-18650-cartridge.snapshot.1/18650.sldprt
sbr-design/Our project/4p-18650-cartridge.snapshot.1/4P.SLDASM
sbr-design/Our project/motor-driver-l298n.snapshot.1/l298n.sldprt
sbr-design/Our project/mpu-6050-imu-sensor-1.snapshot.5/MPU 6050 IMU.SLDASM
sbr-design/Our project/self-balancing-bot-1.snapshot.4/DXF files/Base_top.DXF
sbr-design/Our project/self-balancing-robot-2.snapshot.2/Self Balancing robot/Nut.SLDPRT
sbr-design/Our project/self-balancing-robot-2.snapshot.2/Self Balancing robot/Wheet_nut.SLDPRT
