HedayaAli/Self-balancing-/(commit log)

2017-11-30 Motor-wheel coupler
    [Coupler.SLDPRT]
2017-12-01 New Motor
    [Assem1-1.SLDASM, Coupler.SLDPRT, L HOLDER DC MOTOR.SLDPRT, Motor holder.SLDPRT, MotorHolder.SLDASM]
2017-12-01 coupler for 3D Printing
    [Coupler.SLDPRT]
2017-12-01 Noew Motor Plate
    [Base Plate.SLDPRT, Coupler.SLDPRT, L HOLDER DC MOTOR.SLDPRT, Motor holder.SLDPRT, MotorHolder.SLDASM, Plate.SLDPRT]
2017-12-01 Added New Base
    [MotorHolder.SLDASM]
2017-12-02 renamed directory
    to tidy up :)
    [18650.sldprt, 4P.SLDASM, 4P.STEP, 4P_TRAY.sldprt, ArduinoMega2560.SLDPRT, Assem1-1.SLDASM, Assem1.SLDASM, Assem2.SLDASM]
2017-12-02 Cleaning the mess :P
    Cleaning the mess :P
    [18650.sldprt, 4P.SLDASM, 4P.STEP, 4P_TRAY.sldprt, ArduinoMega2560.SLDPRT, Assem1-1.SLDASM, Assem1.SLDASM, Assem2-1.SLDASM]
2017-12-02 Cleaning the mess merged :S
    [18650.sldprt, 4P.SLDASM, 4P.STEP, 4P_TRAY.sldprt, ArduinoMega2560.SLDPRT, Assem1.SLDASM, Assem2-1.SLDASM, Assem2.SLDASM]
2017-12-02 Cleaning again...
    [Plate.SLDPRT]
2017-12-02 New wheels
    [65mm tire.SLDPRT, Assem2-1.SLDASM, Coupler.SLDPRT, blue_wheel_frame.SLDPRT, blue_wheel_v1.SLDASM, blue_wheel_with_adapter.SLDASM, motor_adapter.SLDPRT]
2017-12-02 Motor spf
2017-12-05 Robot with pwm now!!!
2017-12-05 More pictures of the robot
    [Assem2-1.SLDASM]
